MEO41/jetsuite2/README.md

# jetsuite2 — micro-turbojet design, analysis and validation suite (v3)

Single-spool, centrifugal-compressor turbojets, 100–1000 N.  From a thrust target and a
mission to a Pareto-justified design with quantified envelope performance, margins,
uncertainty and a test-ready package.

```
core (sub-second, every run):
  requirements -> cycle -> speed -> compressor -> turbine -> combustor -> layout -> rotor -> mechanical -> geometry -> cad
analysis (opt-in, cached, value-hash invalidated like everything else):
  maps -> offdesign -> envelope -> transient -> testbench      assess, combustor1d, life, rotordyn, manufacturing
studies (on the fast chain): sweep, doe, optimize (NSGA-II), uq (LHS Monte Carlo), sensitivity (Morris)
hand-off: export cfd/fea packages -> external solver -> ingest results as L3 overrides
test: virtual test bench, instrumentation plan, abort criteria, correlation / calibration against test data
```

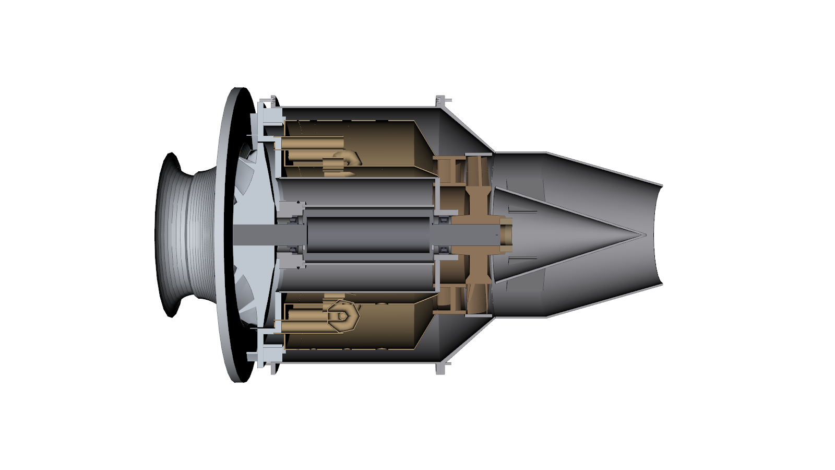
[picture p1: docs/img/p500_section.png]
500 N design, meridional section


## Install

```powershell
uv venv --python 3.12 .venv
$env:VIRTUAL_ENV="$PWD\.venv"; uv pip install -e . pytest
.venv\Scripts\jet --help
```

## Quick start

```powershell
jet new designs\p500 --thrust 500                    # create + core chain (0.4 s)
jet set -d designs\p500 compressor.material=Al2618-T61 --run
jet converge -d designs\p500
jet analyze all -d designs\p500                      # maps, running line, envelope, transients, assessment, life, ... (dependency waves run in parallel processes; --serial, --workers N)
jet status -d designs\p500                           # fidelity tier / staleness / ingested overrides per stage
jet rules -d designs\p500 --all
jet study doe opr_bs --spec '{"variables": {"cycle.OPR": [3.2, 4.6], "compressor.backsweep_deg": [15, 40]}, "n": 32}' -d designs\p500
jet study optimize pareto --spec '{"variables": {"cycle.OPR": [3.2, 4.6], "cycle.T04_K": [1080, 1200]}, "objectives": {"mass_kg": "min", "TSFC": "min"}, "pop": 24, "generations": 10}' -d designs\p500
jet study uq bands -d designs\p500                   # thrust, TSFC, margins as p05/p50/p95
jet study sensitivity rank -d designs\p500
jet export cfd compressor -d designs\p500            # handoff/compressor_cfd: curves, flowpath.step, case.json, ingest_template.json
jet ingest designs\p500\handoff\compressor_cfd\ingest_template.json --run -d designs\p500
jet correlate test_run.csv --calibrate -d designs\p500
jet plot all -d designs\p500                         # layered compressor map (PNG/SVG/HTML), turbine map, Smith/Balje, Campbell
jet freeze -d designs\p500 --by me --note "PDR"      # sign-off snapshot (hash-verifiable); `jet cad` / `jet export` need it (or --unfrozen-ok)
jet compare designs\p500 designs\p500_sched --out designs\p500_sched\compare.md   # side-by-side: rules, margins with bands, running lines, map overlay
jet fe disc -d designs\p500 --ingest                 # CalculiX axisymmetric disc case (native ccx or WSL), ingested as L3 stress
jet fe impeller -d designs\p500 --ingest             # impeller hub case (blades as smeared traction)
jet l3 -d designs\p500                               # every in-suite L3 solve, ingest, re-run, before/after delta (analysis/l3_delta.md)
jet validate paper                                   # three commercial engines modelled from their datasheets, errors reported (docs/validation.md)
jet rig compressor -d designs\p500_sched             # cold-flow compressor test article, drive, instrumentation, run matrix -> handoff/compressor_rig/
jet cfd -d designs\p500_sched --iters 1200           # impeller passage CFD: SU2 RANS-SST, rotating frame, H-mesh, throttle continuation to the design flow; ingest gated (energy balance, docs/validation.md)
jet analyze thermal -d designs\p500                  # secondary air, thermal network (rim/bore/bearing T predicted), oil system, bearing abort setting
jet analyze throughflow -d designs\p500              # impeller meridional through-flow: blade loading, hub-to-shroud incidence, Cm field (L2.5)
jet dashboard -d designs\p500                        # one self-contained HTML: headline, rules with bands, stage status, every plot
jet ecu -d designs\p500_sched                        # controller export: schedules.csv, limits.json, logic.md (state machine, limiter arbitration, faults)
jet drawings -d designs\p500_sched                   # shaft / housings / casing half-section drawings (SVG+PNG) with ISO fits -> handoff/drawings/
jet cam impeller -d designs\p500_sched               # CAM package: blade surface grids, hub/shroud curves, STEP, fillet spec (+ fillet attempt); needs a frozen design
jet set -d designs\p500 control.bleed_enabled=true control.igv_enabled=true --run   # variable geometry / control as design objects
jet validate                                         # every method vs the validation database (`jet validate rigs`: HECC/CC3 surge calibration)
jet cad -d designs\p500 ; jet report -d designs\p500 ; jet readiness -d designs\p500
```

## What v3 adds over v2

* **Fidelity ladder** — every stage carries a tier (L0/L1/L2/L3); `jet status` shows where each
  component stands; ingested solver/test results override stage values with provenance and
  re-trigger the graph; rules carry the tier of the load they were evaluated at.
* **L2 component physics** — mean-line loss models for the compressor (Oh/Aungier set, spanwise
  inducer choke, stall indicators, vaned-diffuser throat/incidence) and the turbine
  (Ainley-Mathieson/Dunham-Came with Kacker-Okapuu scaling), validated against independent
  code and literature (`docs/validation.md`).  1-D combustor network.  Rotordynamics campaign.
* **Quality assessment** — Balje/Cordier placement, slip by four methods with the disagreement
  surfaced, de Haller / diffusion / Coppage loading, incidence across the running line, diffuser
  throat and two-zone mixing, backsweep trade study, Smith chart, Zweifel, hub reaction.
* **Off-design, envelope, transients** — maps with surge and choke lines, running line with
  surge margin, altitude/Mach/dT envelope, start / slam / decel / hot & hung start / overspeed /
  flameout on the rotor inertia.
* **Life** — Larson-Miller creep over a mission, Manson LCF with start thermal stress, bearing
  L10 with lubrication, containment.
* **Optimisation and UQ** — DOE (LHS/Sobol), NSGA-II with the rules as constraints, RBF
  surrogates with leave-one-out error, Morris sensitivity, Monte-Carlo UQ with the validation
  errors as default bands; every study records the base-design hash and is flagged stale.
* **Test loop** — virtual test bench (log CSV, plots), instrumentation plan, abort criteria,
  test-readiness report, correlation and calibration against measured data.
* **Manufacturability** — tolerance stack-up, ISO 21940 balance requirement, 5-axis
  machinability screen, process-dependent allowables, BOM with part numbers and cost/lead.

## Verification

`pytest` — v2 suite (gas model, invalidation, rotordynamics closed forms, thrust sweep,
boomsonic_v0 regression) plus `tests/test_v3.py` (tabulated thermo, loss-model validation
tolerances, tiers/ingest, maps and matching closure, studies).  `jet validate` prints the
model-vs-reference table (`docs/validation.md`).

## Documents

`docs/architecture.md`, `docs/kernel_evaluation.md`, `docs/design_rules.md`, `docs/validation.md`, `CLAUDE.md`.
