MEO41/jetsuite2/designs/p500_sched/dashboard.html

# p500 v0055 fail not frozen

Generated 2026-09-17T06:31:28+00:00. never frozen. Every number carries its tier; a margin that mixes tiers is reported at the lowest one.

## Headline

thrust_N | airflow_kg_s | TSFC_kg_N_h | rpm | D2_mm | turbine_tip_mm | OD_mm | length_mm | mass_kg | bearing | verdict
500 | 0.8674 | 0.1192 | 7.25e+04 | 131.4 | 112.6 | 183.3 | 378.7 | 6.66 | 71902C-HC | fail

## Rules

id | rule | value | limit | margin | verdict | tier | source / band
REQ-1 | thrust target inside supported range | 500 | 1000 N | +50.0 % | pass | L0 | brief: 100-1000 N
REQ-2 | thrust target above minimum | 500 | 100 N | +400.0 % | pass | L0 | brief: 100-1000 N
REQ-3 | design Mach subsonic (pitot intake model) | 0 | 1 | +100.0 % | pass | L0 | intake model: normal shock + duct
CYC-1 | OPR within single-stage centrifugal practice | 4 | 5 | +20.0 % | pass | L1 | Dixon & Hall ch.7; micro-turbojet fleet 2.5-4.5
CYC-2 | OPR above useful minimum | 4 | 2.2 | +81.8 % | pass | L1 | cycle: specific thrust collapses below ~2.2
CYC-3 | T04 within uncooled cast-wheel practice | 1150 | 1250 | +8.0 % | pass | L1 | IN-713LC/MAR-M247 uncooled rotor practice (JetCat/AMT class 1050-1200 K)
CYC-4 | T04 above combustor stability floor | 1150 | 950 | +21.1 % | pass | L1 | lean stability at idle/design
CYC-5 | compressor exit temperature vs aluminium impeller limit (info) | 461.1 | - K | - | info | L1 | materials.T_max
CYC-6 | nozzle pressure ratio | 1.893 | - - | - | info | L1 | -
CYC-7 | fuel-air ratio below 60 % stoichiometric | 0.01928 | 0.04098 | +53.0 % | pass | L1 | combustor: overall phi < 0.6
SPD-1 | inducer shroud relative Mach at design | 1.095 | 1.3 | +15.8 % | pass | L1 | fielded micro-turbojet band 1.10-1.33 (boomsonic_v0 A3R.1)
SPD-2 | design rpm vs turbine AN2 limit | 7.25e+04 | 8.52e+04 rpm | +14.9 % | pass | L1 | AN2 with IN713LC allowable 436 MPa at 1030 K, margin 1.25
SPD-2b | design rpm vs turbine disc bore-stress limit | 7.25e+04 | 7.494e+04 rpm | +3.3 % | pass | L1 | bored IN713LC wheel, allowable 631 MPa at 750 K, k_peak 1.3
SPD-3 | design rpm vs bearing DN limit | 7.25e+04 | 8.095e+04 rpm | +10.4 % | pass | L1 | bearing 71902C-HC DN 1.5e+06 x 0.85
SPD-4 | impeller tip speed allowed by material (info: set by work, see COMP-3) | 454.1 | - m/s | - | info | L1 | Ti-6Al-4V yield at Tt3
COMP-1 | inducer shroud relative Mach | 1.095 | 1.3 | +15.8 % | pass | L1 | fielded micro-turbojet band (boomsonic A3R.1)
COMP-2 | impeller tip speed U2 | 498.8 | 620 m/s | +19.5 % | pass | L1 | Ti impellers ~550-600 m/s, Al ~450-500 (Dixon; Rodgers)
COMP-3 | exducer root stress at MCS vs allowable (root sized to the limit) | 602.6 | 602.6 MPa | +0.0 % | pass | L1 | Ti-6Al-4V yield at 461 K / SF 1.0
COMP-4 | impeller material temperature (Tt3) | 461.1 | 673 K | +31.5 % | pass | L1 | Ti-6Al-4V T_max
COMP-5 | exit width ratio b2/D2 | 0.05856 | 0.03 | +95.2 % | pass | L1 | narrow exits lose efficiency (Rodgers): b2/D2 >= 0.03
COMP-6 | relative diffusion ratio W1s/W2 | 1.717 | 2 | +14.1 % | pass | L1 | Dixon & Hall / Rodgers: W1s/W2 <= ~1.8-2.0 for attached flow
COMP-7 | inducer throat choke margin at design | 0.486 | 0.1 | +386.0 % | pass | L1 | Rodgers: design at <= 90 % of throat choke flow (boomsonic A3R.5)
COMP-7b | inducer throat not choked at design | 0.486 | 0 | +48.6 % | pass | L1 | throat mass-flow function
COMP-8 | radius ratio r2/r1s | 1.563 | 1.3 | +20.3 % | pass | L1 | Aungier: 1.4-2.2 for a radial impeller
COMP-9 | radius ratio r2/r1s upper | 1.563 | 2.3 | +32.0 % | pass | L1 | Aungier: 1.4-2.2 for a radial impeller
COMP-10 | impeller exit absolute Mach | 0.9246 | 1.1 | +15.9 % | pass | L1 | vaned diffuser LE tolerates ~M 1.1 (Japikse)
COMP-11 | diffuser inlet flow angle from radial | 70.02 | 78 | +10.2 % | pass | L1 | vaneless stability: alpha < ~78 deg (Senoo)
COMP-12 | estimated vs assumed stage efficiency |diff| | 0.00235 | 0.03 | +92.2 % | pass | L1 | consistency: run `jet converge`
COMP-13 | backsweep angle | 30 | 45 | +33.3 % | pass | L1 | manufacturing/loading practice 15-45 deg
COMP-14 | backsweep angle minimum for stability | 30 | 15 | +100.0 % | pass | L1 | range/stability practice
COMP-15 | implied diffuser total-pressure loss | 0.08097 | 0.12 | +32.5 % | pass | L1 | impeller/diffuser split: 3-10 % typical
TURB-1 | stage loading psi | 1.46 | 2.4 | +39.2 % | pass | L1 | Smith chart: efficiency falls fast above ~2.2
TURB-2 | stage loading psi minimum | 1.46 | 1.2 | +21.7 % | pass | L1 | below ~1.2 the annulus becomes very short
TURB-3 | rotor-exit hub/tip ratio | 0.62 | 0.55 | +12.7 % | pass | L1 | practice 0.6-0.85 for a single stage
TURB-4 | rotor-exit hub/tip ratio upper | 0.62 | 0.88 | +29.5 % | pass | L1 | very short blades: clearance losses
TURB-5 | blade root stress at MCS x margin vs allowable | 372.2 | 436 MPa | +14.6 % | pass | L1 | IN713LC min(yield, creep) at 1030 K; margin 1.25
TURB-6 | rotor metal temperature vs material limit | 1030 | 1223 K | +15.8 % | pass | L1 | IN713LC T_max
TURB-7 | NGV metal temperature vs material limit | 1150 | 1223 K | +6.0 % | pass | L1 | IN713LC T_max
TURB-8 | NGV exit Mach | 0.8164 | 1.05 | +22.2 % | pass | L1 | subsonic/transonic NGV practice
TURB-9 | rotor exit absolute Mach | 0.376 | 0.6 | +37.3 % | pass | L1 | jet-pipe entry Mach; boomsonic R7.1 annulus cap
TURB-10 | estimated vs assumed turbine efficiency |diff| | 0.001809 | 0.03 | +94.0 % | pass | L1 | consistency: run `jet converge`
TURB-11 | AN2 (rotor annulus x rpm^2) at MCS | 3.554e+07 | 4.5e+07 m2rpm2 | +21.0 % | pass | L1 | uncooled cast wheels: JetCat/AMT class 2-3.5e7, ceiling ~4.5e7 m2 rpm2
TURB-12 | turbine tip diameter (info) | 112.6 | - mm | - | info | L1 | -
COMB-1 | reference velocity | 14.36 | 25 m/s | +42.5 % | pass | L1 | Lefebvre: annular 15-25 m/s; micro practice ~20
COMB-2 | reference velocity minimum | 14.36 | 12 m/s | +19.7 % | pass | L1 | low U_ref wastes volume
COMB-3 | liner residence time | 2.5 | 2.5 ms | +0.0 % | pass | L1 | vaporiser combustors 4-7 ms (JetCat/AMT class)
COMB-4 | liner length / height | 2.8 | 3.6 | +22.2 % | pass | L1 | practice 2.5-3.5 (Lefebvre)
COMB-5 | liner metal temperature margin (T04 vs liner T_max; film-cooled liners run cooler) | 1150 | 1403 K | +18.0 % | pass | L1 | IN625 T_max + 150 K film credit
COMB-6 | heat release rate | 143.8 | 300 MW/m3bar | +52.1 % | pass | L1 | large annular 20-60, micro-turbojet vaporiser combustors up to ~300 MW/(m3 bar)
COMB-7 | air split sums to 1 | 1 | 1 | +0.0 % | pass | L1 | input check
COMB-8 | vaporiser fuel loading | 4.257 | 12 kg/h | +64.5 % | pass | L1 | practice 3-12 kg/h per tube
LAY-1 | engine outer diameter vs limit | 183.3 | - mm | - | info | L0 | requirements.max_diameter_mm
LAY-2 | engine length vs limit | 378.7 | - mm | - | info | L0 | requirements.max_length_mm
LAY-3 | bearing span / D2 (rotordynamic sanity) | 0.8223 | 2.2 | +62.6 % | pass | L0 | long spans lower the bending critical; boomsonic_v0 1.43
LAY-4 | tail cone shorter than nozzle | 0.1075 | 0.1193 | +9.9 % | pass | L0 | geometry
ROT-1 | bearing DN at MCS vs rating | 1.142e+06 | 1.5e+06 mm.rpm | +23.9 % | pass | L2 | 71902C-HC catalogue DN limit
ROT-2 | bearing temperature rating | 420 | 523 K | +19.7 % | pass | L2 | 71902C-HC T_max
ROT-3 | first bending critical / MCS | 2.5 | 1.25 | +100.0 % | pass | L2 | API 684 separation margin practice (25 %)
ROT-4 | rigid-body criticals below 60 % speed (soft mount) | 0.4024 | 0.6 | +32.9 % | pass | L2 | traverse rigid modes below idle-to-cruise band
ROT-5 | journal torsional stress | 30.46 | 175.3 MPa | +82.6 % | pass | L2 | AISI4340 0.577 Fty / SF 3
ROT-6 | tube torsional stress | 3.013 | 175.3 MPa | +98.3 % | pass | L2 | AISI4340 0.577 Fty / SF 3
ROT-7 | shaft tunnel fits inside combustor inner casing | 0.0215 | 0.03821 m | +43.7 % | pass | L2 | layout: tunnel OD + 3 mm gap
ROT-8 | bearing L10 life (info) | 6.251e+06 | - h | - | info | L2 | ISO 281 basic rating (no thermal factors)
MECH-1 | impeller disc peak stress at MCS vs yield | 738.5 | 617 MPa | -19.7 % | fail | L1 | Ti-6Al-4V min-basis yield at 441 K; stress from L3 FE (CalculiX 2.21 axisymmetric CAX4 impeller)
MECH-2 | impeller burst speed ratio | 1.531 | 1.2 | +27.6 % | pass | L1 | 14 CFR 33.27 style; Robinson k 0.85
MECH-3 | inducer root radial stress vs yield | 130.9 | 617 MPa | +78.8 % | pass | L1 | Ti-6Al-4V yield
MECH-4 | exducer root stress (from compressor stage, sized to limit) vs allowable | 602.6 | 602.6 MPa | +0.0 % | pass | L1 | compressor.COMP-3
MECH-5 | turbine disc peak stress vs bore allowable | 967.1 | 630.8 MPa | -53.3 % | fail | L1 | IN713LC allowable at bore 750 K; stress from L3 FE (CalculiX 2.21 axisymmetric CAX4 disc, 23)
MECH-6 | turbine disc average stress vs rim creep allowable | 398.4 | 615.9 MPa | +35.3 % | pass | L1 | IN713LC allowable at rim 950 K
MECH-7 | turbine burst speed ratio | 1.267 | 1.2 | +5.6 % | pass | L1 | 14 CFR 33.27 style; Robinson k 0.85
MECH-8 | turbine blade root (from turbine stage) | 297.8 | 436 MPa | +31.7 % | pass | L1 | turbine.TURB-5 (no margin factor here)
MECH-9 | impeller clamp load retained hot | 5.897e+04 | 1.435e+04 N | +311.0 % | pass | L1 | tie-shaft preload minus thermal relaxation and gas load >= 20 % of preload
GEO-1 | dry mass estimate vs limit | 6.66 | - kg | - | info | L0 | requirements.max_mass_kg
GEO-2 | thrust/weight (info) | 7.653 | - - | - | info | L0 | -
GEO-3 | flange screws count (info) | 15 | - | - | info | L0 | ISO 4762 M2
CTL-8 | IGV actuation rate required vs capability | 9.375 | 30 deg/s | +68.8 % | pass | L1 | schedule slope x fastest class acceleration (idle -> 95 % in 4 s)
CTL-9 | IGV failure position defined (open = 0 deg, closed = max) | 1 | 1 | +0.0 % | pass | L1 | a failed actuator must leave the vanes at a known position; the transient stage runs the failed case
CTL-1 | bleed fraction at full opening | 0.15 | 0.15 | +0.0 % | warn | L1 | handling bleeds 5-15 % (Saravanamuttoo)
CTL-2 | variable nozzle area range A8_low / A8_design | 1.3 | 1.35 | +3.7 % | warn | L1 | translating-plug / iris practice 1.0-1.3
CTL-3 | IGV pre-swirl range | 25 | 40 | +37.5 % | pass | L1 | IGV practice <= 30-40 deg
CTL-4 | accel line above decel line everywhere | 0.7 | 0.3 | +133.3 % | pass | L1 | limiter ordering: accel multiplier - decel multiplier >= 0.3
CTL-5 | accel limiter at design speed | 1.183 | 1.35 | +12.3 % | pass | L1 | practice: 1.1-1.3 x steady Wf/P3 near max
CTL-6 | idle governor speed | 0.5 | 0.35 | +42.9 % | pass | L1 | micro-turbojet idle 30-50 %
CTL-7 | start ramp rate (fraction of accel line per s) | 0.25 | 1 | +75.0 % | pass | L1 | faster ramps raise the start T04 peak and the disc thermal gradient (F3)
ASS-1 | compressor quality score (mean of items) | 0.8499 | 0.75 | +13.3 % | pass | L2 | assessment items AQ-C*
ASS-2 | diffuser quality score | 1 | 0.75 | +33.3 % | pass | L2 | AQ-D*
ASS-3 | turbine quality score | 0.9805 | 0.75 | +30.7 % | pass | L2 | AQ-T*
TF-1 | pressure-side relative velocity stays positive (no blade overload / reverse flow) | 3.882 | 0 m/s | +388.2 % | pass | L2 | Stanitz loading on the blade-aligned through-flow (L2.5)
TF-2 | suction-side deceleration ratio W_ss,max / W_ss,exit (worst streamline) | 1.933 | 1.6 | -20.8 % | fail | L2 | Dean / Rodgers: suction-surface diffusion <= ~1.6 before separation
TF-3 | leading-edge incidence spread hub -> shroud | 4.258 | 6 deg | +29.0 % | pass | L2 | twist matched to the inlet velocity profile
TF-4 | exit meridional velocity distortion Cm_shroud / Cm_hub | 1.031 | 1.5 | +31.3 % | pass | L2 | curvature-driven hub/shroud imbalance feeding the diffuser
TF-5 | blade loading parameter (W_ss - W_ps) / W_mean, max | 1.963 | 0.9 | -118.1 % | warn | L2 | Aungier / Stanitz practice 0.7-1.0
C1D-1 | primary-zone equivalence ratio | 1.201 | 1.4 | +14.2 % | pass | L2 | Lefebvre: primary zone phi 0.8-1.4 for vaporiser combustors
C1D-1b | primary-zone equivalence ratio minimum | 1.201 | 0.8 | +50.1 % | pass | L2 | Lefebvre: phi_pz >= 0.8 for stability
C1D-2 | primary-zone Damkohler number (residence/chemical) | 25.44 | 5 | +408.9 % | pass | L2 | Da >> 1 required for stable combustion (global kinetics; order of magnitude)
C1D-3 | combustion efficiency (Lefebvre theta correlation) | 0.9851 | 0.98 | +0.5 % | pass | L2 | theta correlation calibrated on the fleet (+/-2 pts)
C1D-4 | lean blow-out margin at design (phi_pz / phi_LBO) | 2.402 | 1.5 | +60.2 % | pass | L2 | Lefebvre stability loop
C1D-5 | lean blow-out margin at idle | 1.332 | 1.2 | +11.0 % | pass | L2 | Lefebvre stability loop at the idle point
C1D-6 | pattern factor into the turbine | 0.2698 | 0.3 | +10.1 % | pass | L2 | Lefebvre: PF 0.2-0.35 for short annular liners
C1D-7 | liner wall temperature vs material limit | 978 | 1253 K | +21.9 % | pass | L2 | IN625 T_max; radiation/convection/film balance
C1D-8 | altitude relight index (phi_LBO windmilling / phi_LBO design) | 1.103 | 2.5 | +55.9 % | pass | L2 | Lefebvre loading at 6000 m, N 0.12
MAP-1 | design-point surge margin (loss-model map, SAE definition) | 0.1726 | 0.15 | +15.1 % | warn | L2 | rig-calibrated stall model (HECC/CC3); band +/-0.077 = rig 0.077 (RSS) = 0.077 +0.173 - 0.077 = +0.096 vs limit 0.150: fails with the band (passes nominally); dominant term: rig 0.077
MAP-2 | design-point choke margin (flow to choke / design flow - 1) | 0.1009 | 0.08 | +26.2 % | pass | L2 | inducer / diffuser throat choke on the design speed line
MAP-3 | L2 loss-model compressor efficiency vs L1 estimate |diff| | 0.02339 | 0.04 | +41.5 % | pass | L2 | consistency between fidelity tiers
MAP-4 | L2 loss-model turbine efficiency vs L1 estimate |diff| | 0.03783 | 0.05 | +24.3 % | pass | L2 | consistency between fidelity tiers
MAP-5 | design-point vaned-diffuser incidence | -3.082 | 4 | +177.1 % | pass | L2 | vane stall onset ~ +4-6 deg (Japikse)
MAP-6 | compressor loss-model PR at design vs cycle OPR |diff|/OPR | 0.06767 | 0.06 | -12.8 % | warn | L2 | the sized geometry should deliver the cycle pressure ratio within the loss-model accuracy
OD-1 | minimum surge margin along the running line | 0.06865 | 0.1 | -31.3 % | fail | L2 | SAE margin from the L2 map at N 1.05; band +/-0.077 = rig 0.077 (RSS) = 0.077 +0.069 - 0.077 = -0.008 vs limit 0.100: fails with the band; dominant term: rig 0.077
OD-2 | max-thrust point recovers the design thrust | 0.9872 | 0.95 | +3.9 % | warn | L2 | map-based matching vs design-point cycle (consistency)
OD-3 | idle speed fraction | 0.4 | 0.35 | +14.3 % | pass | L2 | micro-turbojet idle 30-40 % (JetCat 33-35 %)
OD-4 | idle surge margin | 0.3001 | 0.08 | +275.1 % | pass | L2 | low-speed operability (boomsonic_v0 risk 4.2); band +/-0.159 = rig 0.077 + igv extrapolation 0.140 (RSS) = 0.159 +0.300 - 0.159 = +0.141 vs limit 0.080: passes with the band; dominant term: igv extrapolation 0.140
ENV-1 | fraction of envelope grid points cleared (converged, SM >= floor) | 0.7083 | 0.9 | -21.3 % | warn | L2 | SM floor 0.08; L2 maps
ENV-2 | worst-case surge margin over the envelope | -0.04617 | 0.08 | -157.7 % | fail | L2 | at alt 9000.0 m, M 0.6, dT -20.0 K; band +/-0.077 = rig 0.077 (RSS) = 0.077 -0.046 - 0.077 = -0.123 vs limit 0.080: fails with the band; dominant term: rig 0.077
ENV-3 | sea-level static max thrust vs design thrust | 0.9872 | 0.95 | +3.9 % | warn | L2 | envelope max-power point at SLS (T04- or N-limited)
TRN-1 | start reaches idle | 1 | 1 | +0.0 % | pass | L2 | start sequence simulation
TRN-2 | start light-off to self-sustain time | 7.65 | 8 s | +4.4 % | warn | L2 | micro-turbojet practice 3-8 s
TRN-3 | slam acceleration idle -> 95 % time | 7.05 | 6 s | -17.5 % | warn | L2 | class practice 3-6 s (JetCat ~4 s)
TRN-4 | minimum surge margin during the slam acceleration | 0.1719 | 0.05 | +243.8 % | pass | L2 | transient excursion toward surge at N 0.81; band +/-0.082 = rig 0.077 + transient quasi-steady model form 0.030 (RSS) = 0.082 +0.172 - 0.082 = +0.090 vs limit 0.050: passes with the band; dominant term: rig 0.077
TRN-5 | T04 peak during acceleration vs limit | 1200 | 1200 K | +0.0 % | pass | L2 | over-temperature limiter (the limiter holds the peak at the limit)
TRN-6 | deceleration 100 % -> idle time | 0.8 | 8 s | +90.0 % | pass | L2 | class practice
TRN-7 | hot start T04 peak (schedule x1.5) | 1200 | 1300 K | +7.7 % | pass | L2 | abnormal case: rich start
TRN-8 | hung start with half starter torque avoided | 0 | 1 | -100.0 % | warn | L2 | abnormal case
TRN-10 | surge margin with the IGV actuator failed (slam accel, vanes at the failure position) | 0.03416 | 0 | +3.4 % | pass | L2 | failed-open IGV at 0 deg; band +/-0.082 = rig 0.077 + transient quasi-steady model form 0.030 (RSS) = 0.082 +0.034 - 0.082 = -0.048 vs limit 0.000: fails with the band (passes nominally); dominant term: rig 0.077
TRN-9 | overspeed on governor failure (peak N / design) | 0.97 | 1.15 | +15.7 % | pass | L2 | burst margin 1.2 x MCS must cover the overspeed reached before the fuel cut
THM-1 | turbine disc rim temperature vs material limit | 1040 | 1223 K | +15.0 % | pass | L1 | IN713LC T_max; network L1 +/-40 K
THM-2 | turbine disc bore temperature vs shaft / bearing tolerance | 791.5 | 850 K | +6.9 % | pass | L1 | bore heat sinks into the shaft; L1 +/-40 K
THM-3 | rear bearing temperature vs bearing rating | 359.5 | 523 K | +31.3 % | pass | L1 | 71902C-HC T_max; Palmgren heat 197 W, oil 147.9 g/min at dT 40 K
THM-4 | secondary air (leakage + purge) fraction of core flow | 0.01039 | 0.03 | +65.4 % | pass | L1 | labyrinth 3 teeth, c 0.15 mm at r 36.1 mm (Martin)
THM-5 | rim-seal purge fraction vs ingestion minimum | 0.01039 | 0.005 | +107.8 % | pass | L1 | declared minimum (Owen); below it hot gas enters the front cavity
THM-6 | front bearing temperature vs bearing rating | 354.6 | 523 K | +32.2 % | pass | L1 | 71902C-HC T_max
THM-7 | bearing abort setting (predicted + margin) below the bearing rating | 389.5 | 523 K | +25.5 % | pass | L1 | abort = predicted 359 K + 30 K margin
THM-8 | mechanical-stage rim temperature assumption vs prediction |dT| | 89.67 | 40 K | -124.2 % | warn | L1 | assumed 950 K, predicted 1040 K; bore assumed 750 K, predicted 791 K
LIFE-1 | turbine blade creep life over the mission / scatter | 1.117e+06 | 50 h | +2233160.2 % | pass | L1 | Larson-Miller from the IN713LC creep table (C 20.0), Robinson damage
LIFE-2 | turbine disc rim creep life / scatter | 7.616e+04 | 50 h | +152221.9 % | pass | L1 | as LIFE-1
LIFE-3 | impeller bore LCF cycles / scatter | 343.3 | 500 | -31.3 % | fail | L1 | Manson universal slopes, Ti-6Al-4V
LIFE-4 | turbine bore LCF cycles incl. start thermal stress / scatter | 14.19 | 500 | -97.2 % | fail | L1 | Manson universal slopes (L1), IN713LC; bore stress 1281 MPa from L3 FE stress (CalculiX 2.21 axisymmetric CAX4 disc, 2379 elements, 2026-09); thermal dT_max 342 K; T thermal network L1 +/-40 K
LIFE-5 | bearing L10 life (ISO 281, lubrication/temperature factors) | 320.2 | 200 h | +60.1 % | pass | L1 | 71902C-HC C 4.0 kN, P_eq 358 N, oil-mist
LIFE-6 | bearing DN with the lubrication method | 1 | 1 | +0.0 % | pass | L1 | catalogue DN x lubrication factor
LIFE-7 | casing wall vs containment thickness (1/3 disc fragment at burst) | 1 | 7.262 mm | -86.2 % | warn | L1 | energy balance, AISI321 UTS at 700 K, k 3 (conceptual)
RD-1 | first forward bending critical / MCS (nominal support) | 2.5 | 1.25 | +100.0 % | pass | L2 | API 684 separation margin
RD-2 | max synchronous vibration amplitude at G2.5 residual unbalance | 1.321 | 25 um | +94.7 % | pass | L2 | ISO 1940 G2.5; 25 um pk at the wheels is a common limit for tip clearance/seal rub
RD-3 | amplification factor at the first response peak | 3.313 | 8 | +58.6 % | pass | L2 | API 684: AF < 8 for a well-damped critical
RD-4 | blade resonance crossings within the operating range | 0 | 0 | +0.0 % | pass | L2 | Campbell: exducer vs diffuser vane passing, turbine blade vs NGV passing
RD-5 | blade resonance within +/-10 % of the design speed | 0 | 0 | +0.0 % | pass | L2 | no crossing at the dwell speed
RD-6 | max bearing dynamic load at G2.5 / static capacity C0 | 0.005321 | 0.1 | +94.7 % | pass | L2 | dynamic load should stay a small fraction of C0
MFG-1 | impeller tip clearance remaining at worst-case stack-up | 0.09279 | 0.05 mm | +85.6 % | pass | L1 | tolerance chain (worst case)
MFG-2 | turbine tip clearance remaining at worst-case stack-up | 0.01 | 0.05 mm | -80.0 % | fail | L1 | tolerance chain incl. thermal growth
MFG-3 | impeller efficiency scatter from clearance tolerance (RSS) | 0.002892 | 0.01 | +71.1 % | pass | L1 | 0.3 x d(clr)/b2
MFG-4 | balancing: required residual per plane vs achievable | 0.3064 | 0.05 g mm | +512.9 % | pass | L1 | ISO 21940 G2.5 at 72500 rpm: 0.306 g mm per plane
MFG-5 | minimum impeller passage width vs cutter | 12.26 | 3 mm | +308.7 % | pass | L1 | 5-axis cutter access
MFG-6 | impeller blade wrap / pitch (axial-view overlap) | 1.572 | 1.6 | +1.8 % | warn | L1 | flank-milling reach
MFG-7 | impeller features flagged | 0 | 0 | +0.0 % | pass | L1 | machinability screen
MFG-8 | turbine casting features flagged | 0 | 0 | +0.0 % | pass | L1 | investment-casting screen
MFG-9 | exducer root stress vs process-adjusted allowable | 602.6 | 602.6 MPa | +0.0 % | pass | L1 | billet-5axis: allowable x 1.0 (root sized to the limit)
MFG-10 | turbine root stress vs process-adjusted allowable | 297.8 | 370.6 MPa | +19.7 % | pass | L1 | investment-cast: allowable x 0.85
TB-1 | virtual run completed without abort | 0 | 0 | +0.0 % | pass | L2 | abort criteria
TB-2 | max thrust reached on the bench vs design | 1.047 | 0.95 | +10.2 % | pass | L2 | throttle step to 100 %

## Stages

stage | kind | tier | last run | stale | overrides (L3)
requirements | core | L0 | 2026-09-16T21:41:31 | | -
cycle | core | L1 | 2026-09-16T21:41:31 | | -
speed | core | L1 | 2026-09-16T21:41:31 | | -
compressor | core | L1 | 2026-09-16T21:41:31 | | -
turbine | core | L1 | 2026-09-16T21:41:31 | | -
combustor | core | L1 | 2026-09-16T21:41:31 | | -
layout | core | L0 | 2026-09-16T21:41:31 | | -
rotor | core | L2 | 2026-09-16T21:41:31 | | -
mechanical | core | L1 | 2026-09-17T00:34:00 | | impeller.sigma_peak_Pa [L3], turbine.sigma_peak_Pa [L3], turbine.sigma_avg_Pa [L3]
control | core | L1 | 2026-09-16T21:41:31 | | -
geometry | core | L0 | 2026-09-16T21:41:31 | | -
maps | analysis | L2 | 2026-09-16T21:45:19 | | -
offdesign | analysis | L2 | 2026-09-17T09:30:35 | | -
assess | analysis | L2 | 2026-09-16T21:26:14 | | -
throughflow | analysis | L2 | 2026-09-17T09:01:28 | | -
combustor1d | analysis | L2 | 2026-09-17T09:31:22 | | -
envelope | analysis | L2 | 2026-09-16T21:35:13 | | -
transient | analysis | L2 | 2026-09-17T09:31:22 | | -
thermal | analysis | L1 | 2026-09-17T09:30:35 | | -
life | analysis | L1 | 2026-09-17T09:31:22 | | sigma_bore_total_Pa [L3]
rotordyn | analysis | L2 | 2026-09-17T09:30:35 | | -
manufacturing | analysis | L1 | 2026-09-17T09:30:35 | | -
testbench | analysis | L2 | 2026-09-17T09:31:22 | | -

## Plots

compressor_map.png

turbine_map.png

smith_balje.png

campbell.png

envelope.png

rotordynamics.png

testbench_run.png

compressor_map.png

running_line.png

throughflow.png

transients.png

turbine_map.png

## Open findings (failed rules)

- MECH-1 impeller disc peak stress at MCS vs yield: lower U2 (OPR/backsweep), boreless mount, or a stronger material
- MECH-5 turbine disc peak stress vs bore allowable: thicker web/hub, lower rpm
- TF-2 suction-side deceleration ratio W_ss,max / W_ss,exit (worst streamline): hub 1.67, mid 1.59, shroud 1.93; unload the inducer (more incidence margin, smoother beta(m))
- OD-1 minimum surge margin along the running line: lower the running line (larger nozzle), more backsweep, or a bleed / variable geometry
- ENV-2 worst-case surge margin over the envelope: hot-day / high-Mach corners load the compressor: consider a variable nozzle or bleed
- LIFE-3 impeller bore LCF cycles / scatter: lower bore stress: boreless hub or lower U2
- LIFE-4 turbine bore LCF cycles incl. start thermal stress / scatter: slower start, thicker hub, or boreless wheel
- MFG-2 turbine tip clearance remaining at worst-case stack-up:
