MEO41/jetsuite2/designs/paper_p300/datasheet_points.csv

N_rpm | thrust_N | Wf_kg_h | EGT_K | W_kg_s | T_amb_K | P_amb_Pa
105000 | 300 | 47.04 | 1023.15 | 0.50 | 288.15 | 101325
35000 | 14 | 8.59 |  |  | 288.15 | 101325
