MEO41/jetsuite2/designs/p500_sched/handoff/ecu/schedules.csv

Nc_frac | rpm_at_design_theta | WfP3_steady_kg_s_per_Pa | accel_mult | decel_mult | bleed_frac | A8_ratio | igv_deg | T04_steady_K
0.2 | 14500.0 |  | 1.5 | 0.55 | 0.15 | 1.3 | 25.0
0.3 | 21750.0 |  | 1.5 | 0.55 | 0.15 | 1.3 | 25.0
0.4 | 29000.0 | 2.4802610105058686e-08 | 1.45 | 0.5333333333333333 | 0.15 | 1.3 | 25.0 | 863.5697973268473
0.45 | 32625.0 | 2.71035822547676e-08 | 1.4249999999999998 | 0.525 | 0.15 | 1.3 | 25.0 | 866.8142639829052
0.5 | 36250.0 | 2.6885261524721085e-08 | 1.4 | 0.5166666666666667 | 0.12222222222222222 | 1.3 | 25.0 | 818.6958404399275
0.55 | 39875.0 | 2.7389507912093985e-08 | 1.375 | 0.5083333333333333 | 0.09444444444444441 | 1.2571428571428571 | 20.83333333333333 | 803.1397178925387
0.6 | 43500.0 | 2.6745744692243385e-08 | 1.35 | 0.5 | 0.06666666666666667 | 1.2142857142857144 | 16.66666666666667 | 774.425437101337
0.65 | 47125.0 | 2.6842742808469064e-08 | 1.325 | 0.49444444444444446 | 0.038888888888888876 | 1.1714285714285715 | 12.5 | 770.5879389911961
0.7 | 50750.0 | 2.6247944885822877e-08 | 1.3 | 0.4888888888888889 | 0.011111111111111127 | 1.1285714285714286 | 8.33333333333334 | 762.1352136951889
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
