MEO41/jetsuite2/designs/p500/analysis/compressor_map.png

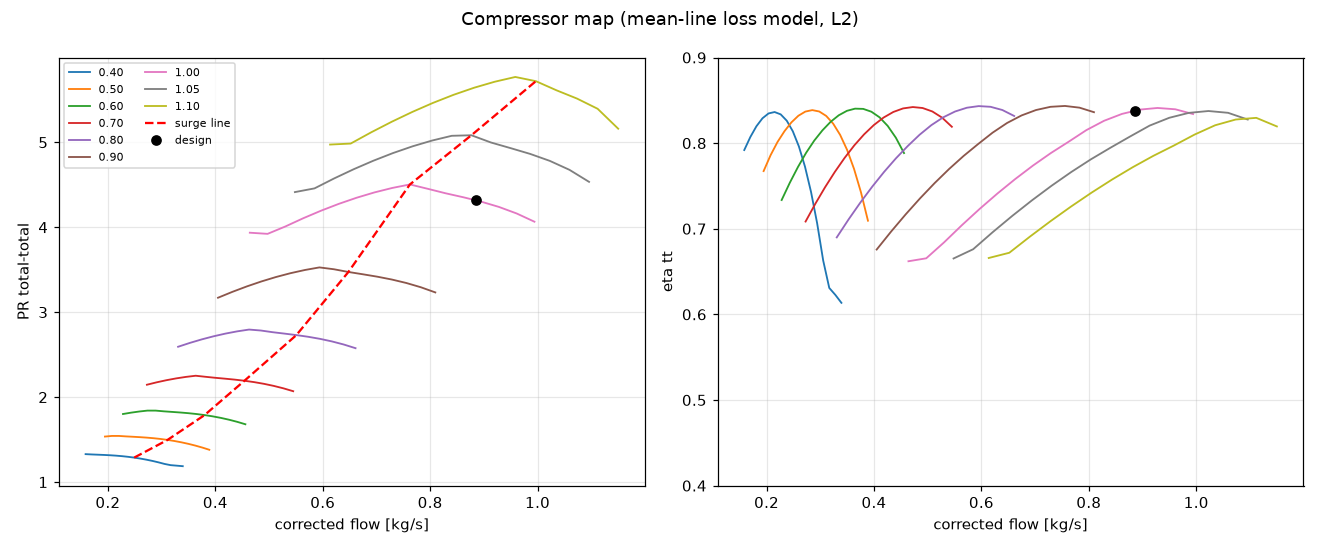
designs/p500/analysis/compressor_map.png
