MEO41/jetsuite2/designs/p500/analysis/envelope.png

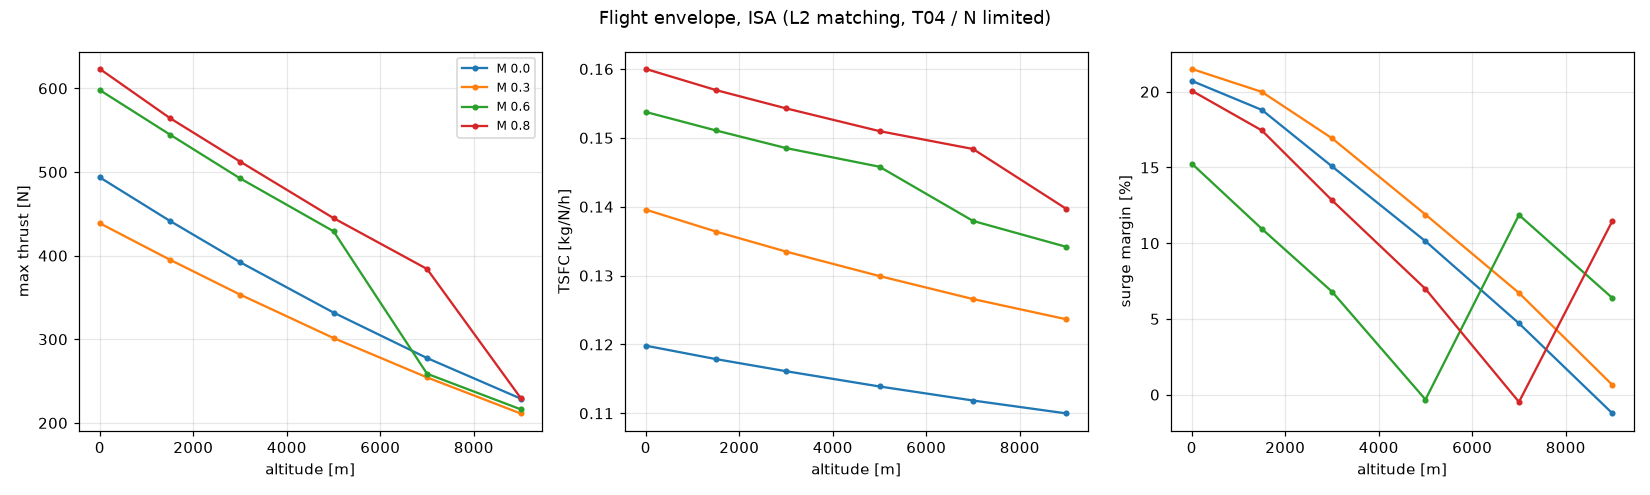
designs/p500/analysis/envelope.png
