MEO41/jetsuite2/designs/p500/analysis/rotordynamics.png

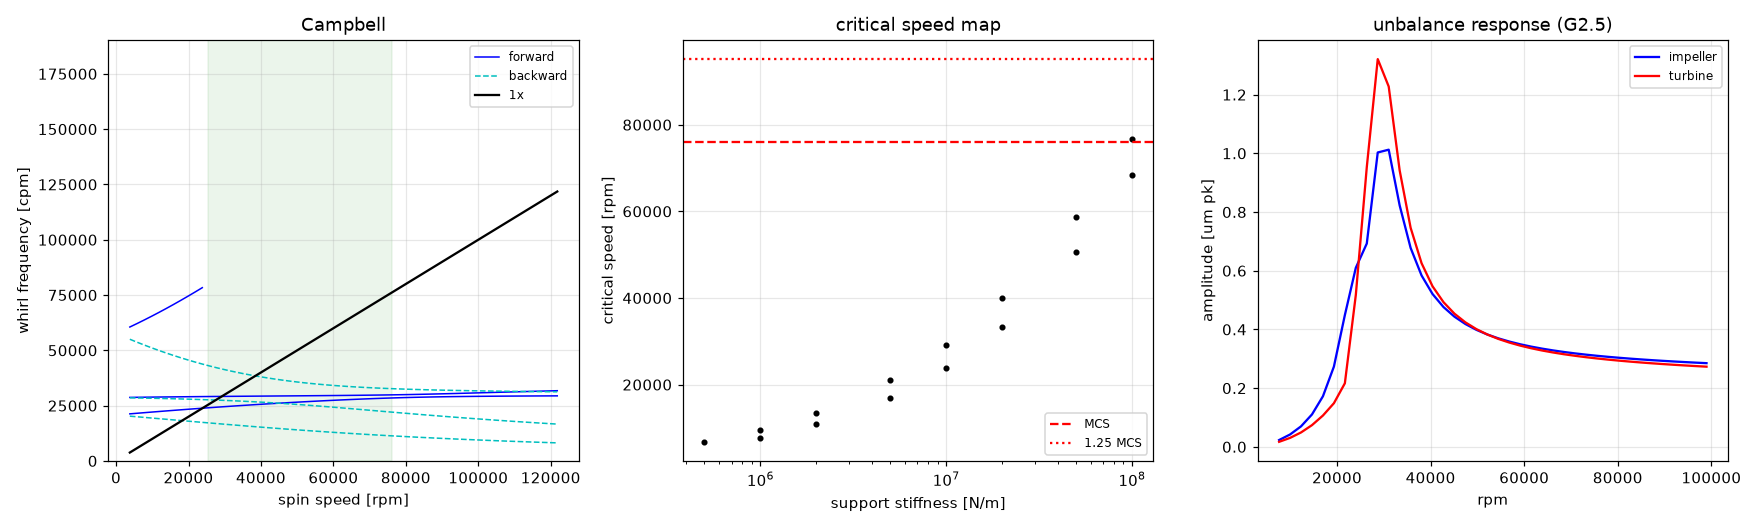
designs/p500/analysis/rotordynamics.png
