MEO41/jetsuite2/designs/p500/analysis/running_line.png

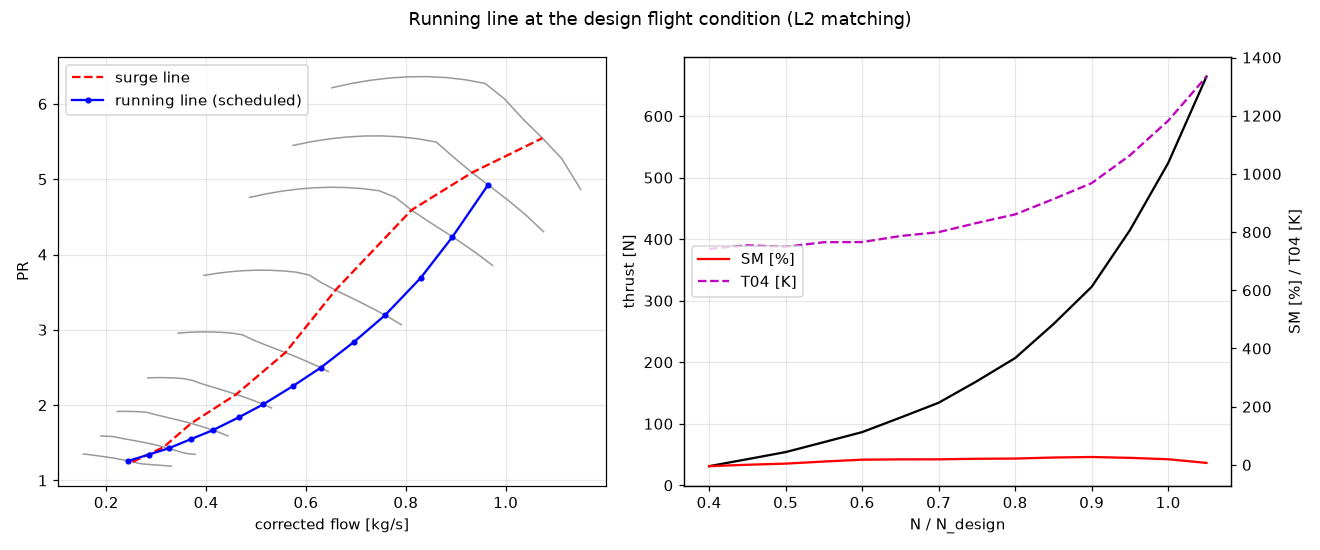
designs/p500/analysis/running_line.png
