MEO41/jetsuite2/designs/p500/analysis/throughflow.png

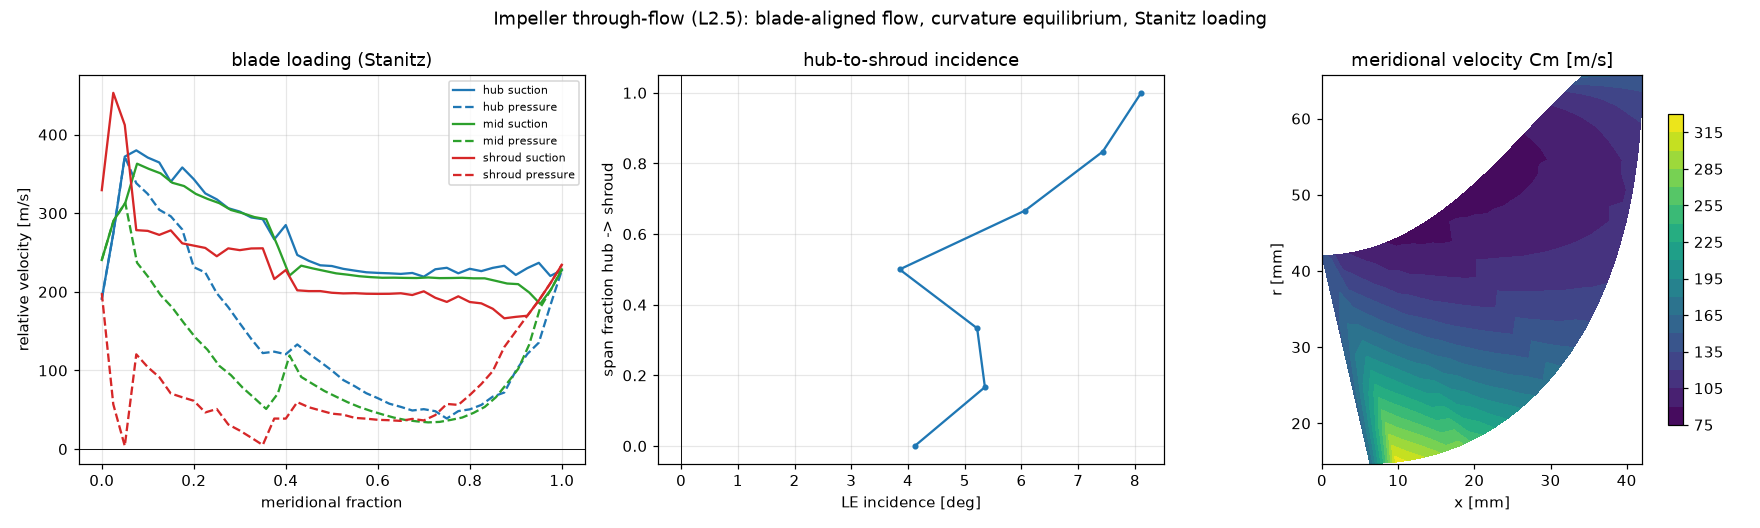
designs/p500/analysis/throughflow.png
