MEO41/jetsuite2/designs/p500/analysis/transients.png

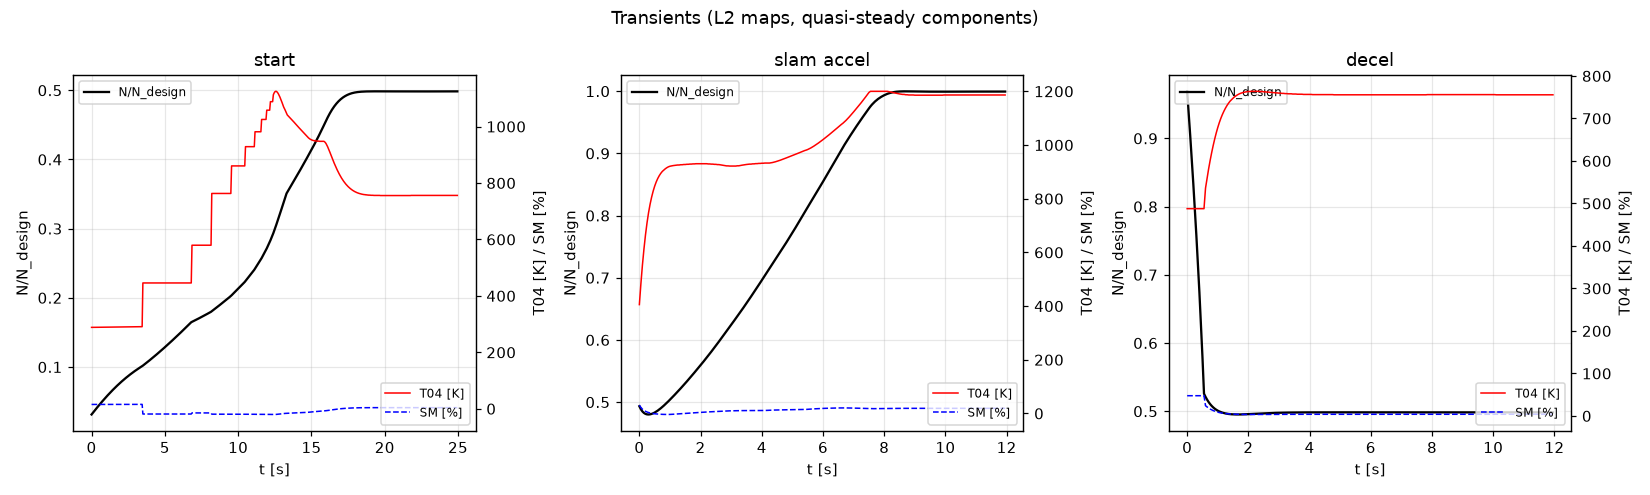
designs/p500/analysis/transients.png
