MEO41/jetsuite2/designs/p500_sched/analysis/compressor_map.png

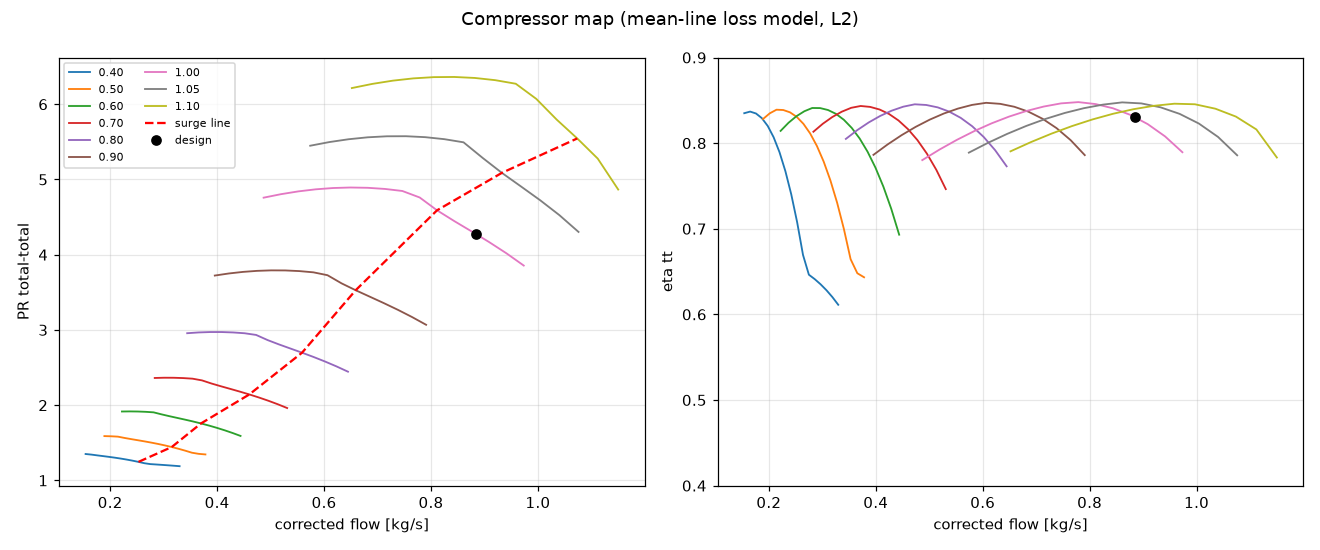
designs/p500_sched/analysis/compressor_map.png
