MEO41/jetsuite2/designs/p500_sched/analysis/transients.png

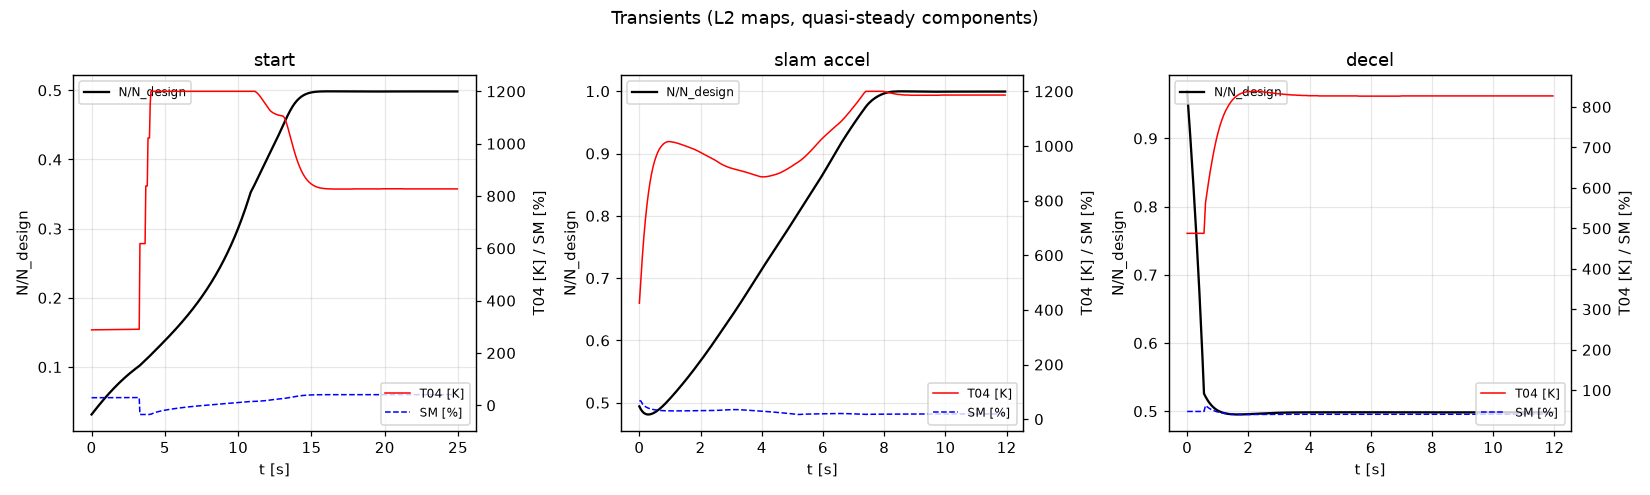
designs/p500_sched/analysis/transients.png
