MEO41/jetsuite2/designs/p500_sched/analysis/turbine_map.png

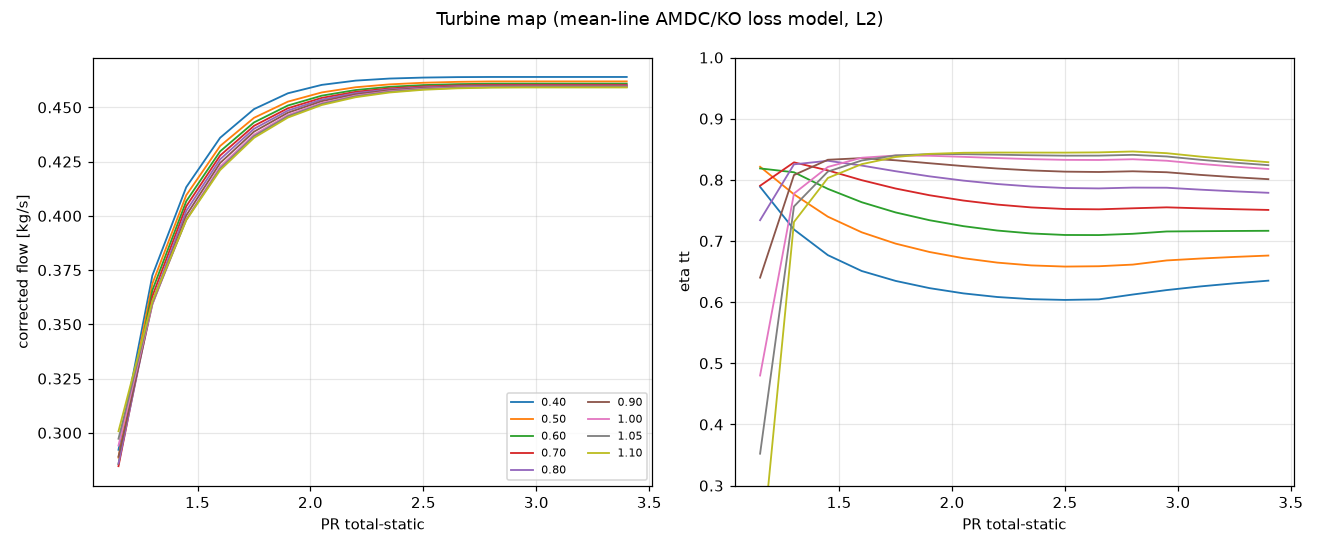
designs/p500_sched/analysis/turbine_map.png
