MEO41/jetsuite2/designs/paper_p300/analysis/turbine_map.png

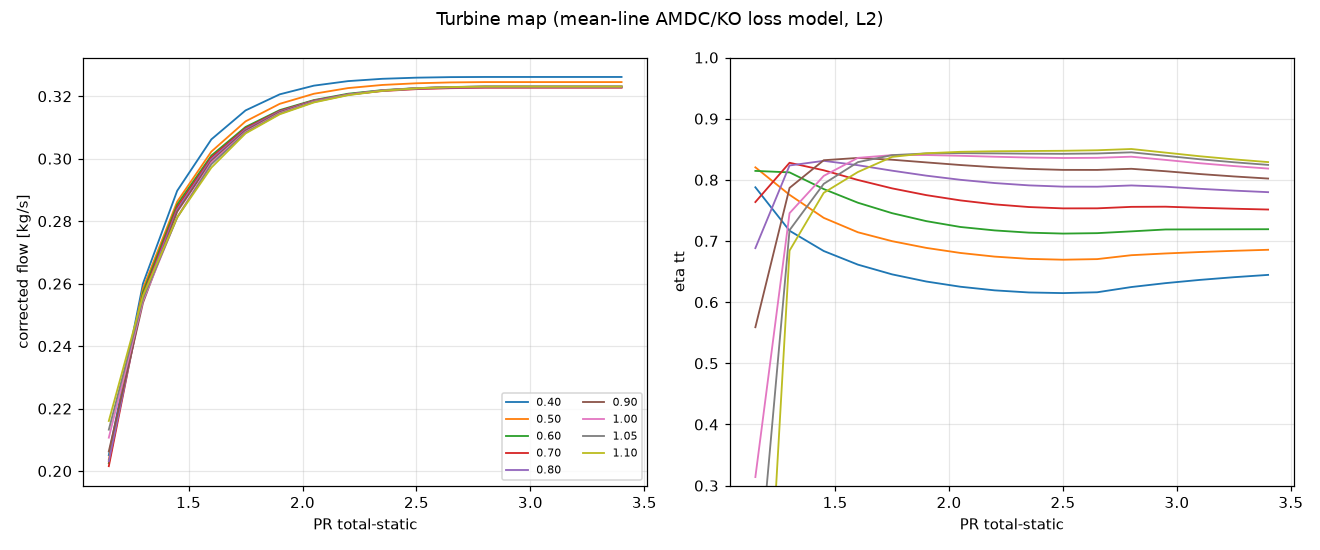
designs/paper_p300/analysis/turbine_map.png
