MEO41/jetsuite2/docs/img/p500_iso.png

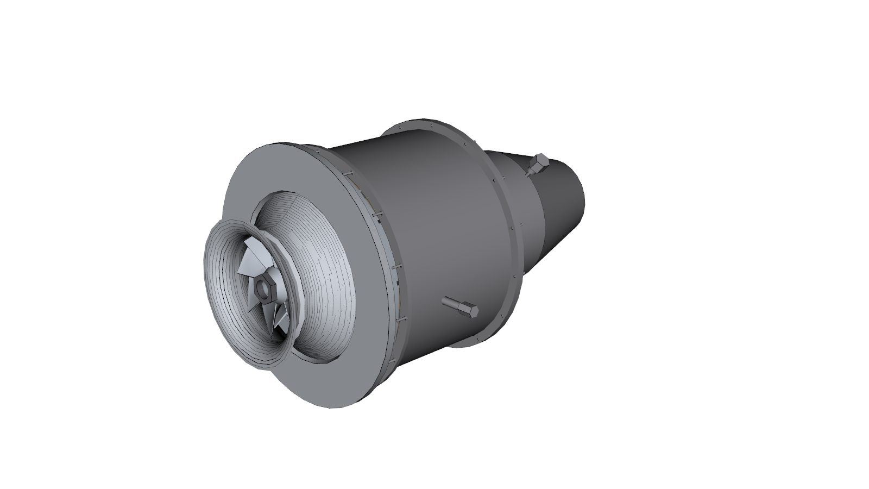
docs/img/p500_iso.png
