MEO41/jetsuite2/designs/p500_sched/cad/engine_assembly.step

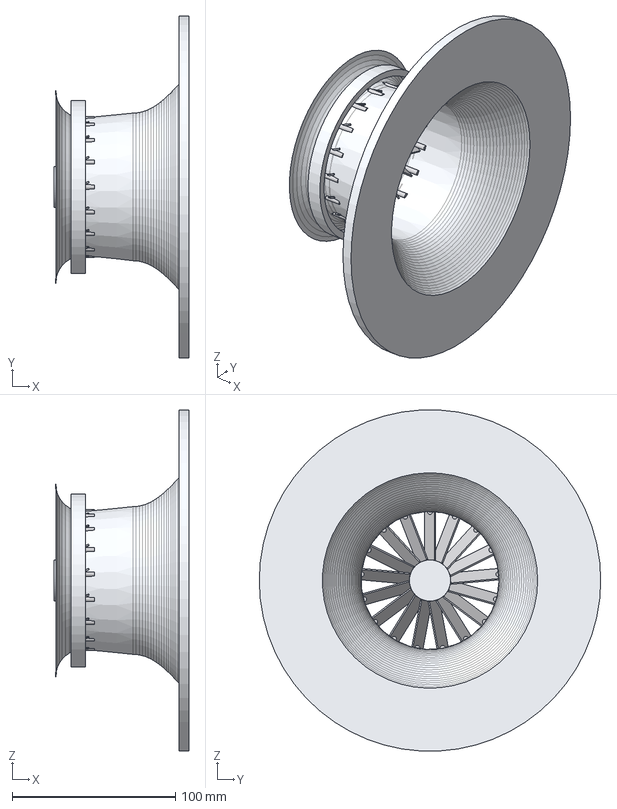
[picture p22: CAD file, 2026-09-17]
designs/p500_sched/cad/engine_assembly.step
82.7 x 209.3 x 209.0 mm
inlet_shroud
igv_vanes
igv_hub_bullet
igv_unison_ring
