MEO41/jetsuite2/designs/p500_sched/handoff/impeller_cam/main_blade.step

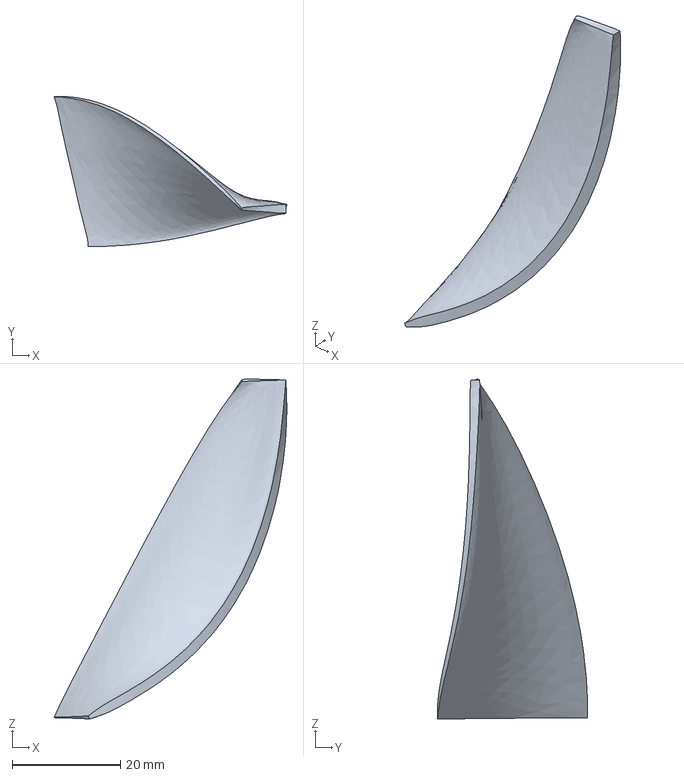
[picture p23: CAD file, 2026-09-17]
designs/p500_sched/handoff/impeller_cam/main_blade.step
42.9 x 27.7 x 62.7 mm
