MEO41/jetsuite2/designs/p500/cad/parts/inlet_shroud.step

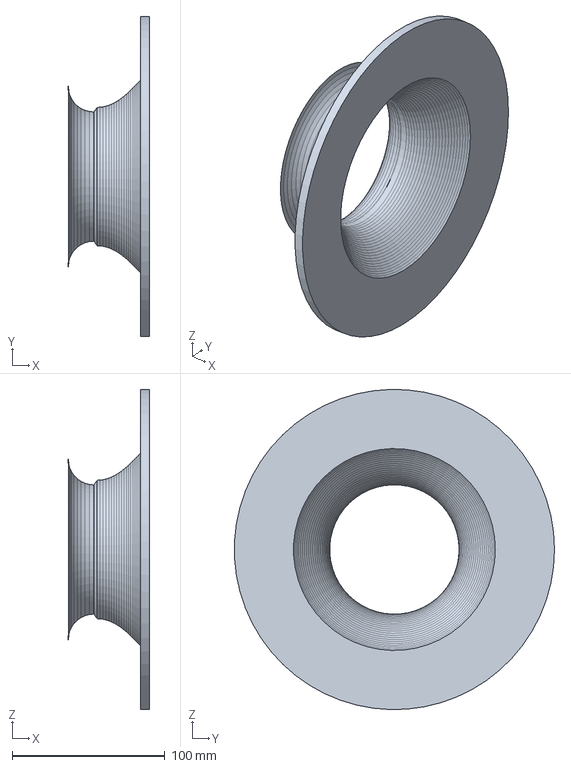
[picture p24: CAD file, 2026-09-16]
designs/p500/cad/parts/inlet_shroud.step
53.3 x 209.2 x 209.3 mm
