MEO41/jetsuite2/designs/p500_sched/cad/parts/igv_unison_ring.step

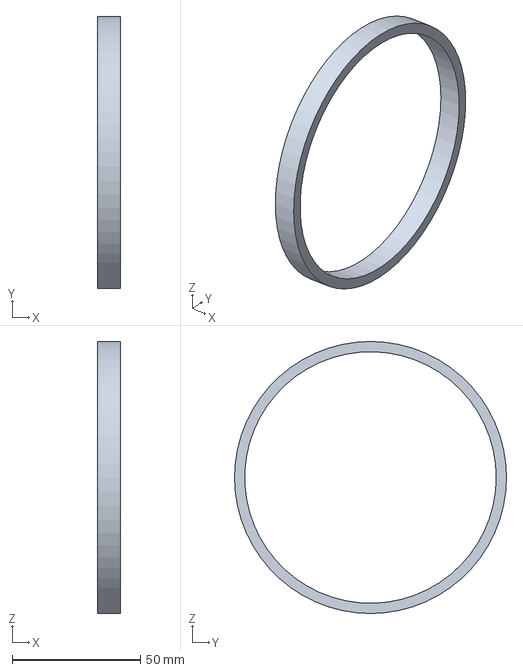
[picture p25: CAD file, 2026-09-17]
designs/p500_sched/cad/parts/igv_unison_ring.step
8.82 x 106.0 x 106.0 mm
