MEO41/jetsuite2/designs/p500_sched/handoff/impeller_cam/hub.step

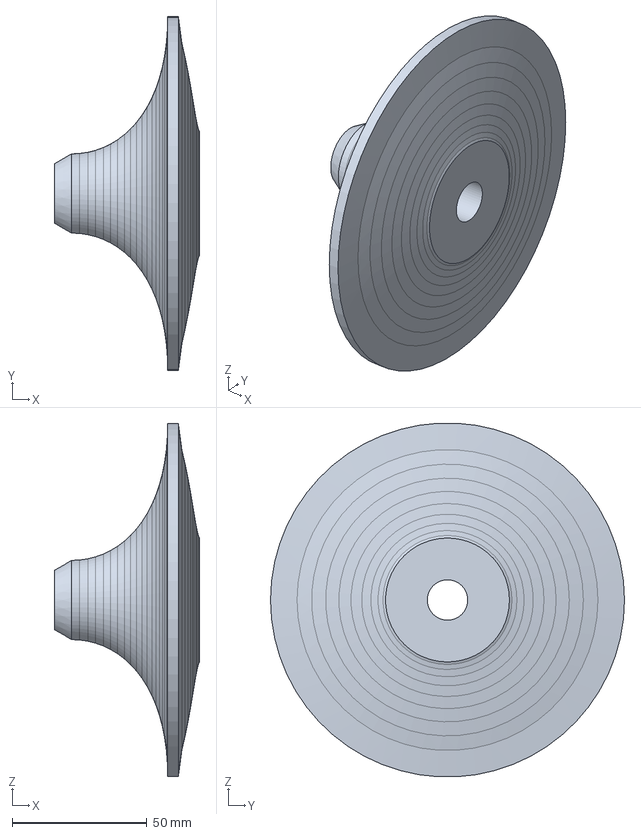
[picture p26: CAD file, 2026-09-17]
designs/p500_sched/handoff/impeller_cam/hub.step
53.9 x 131.4 x 131.2 mm
