MEO41/jetsuite2/designs/p500_sched/handoff/impeller_cfd/passage.step

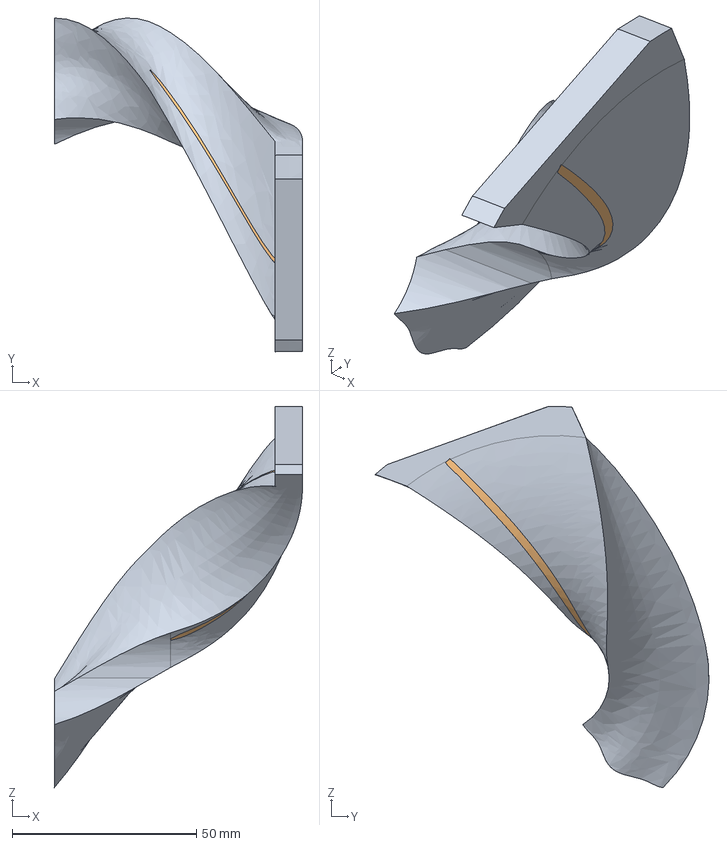
[picture p27: CAD file, 2026-09-17]
designs/p500_sched/handoff/impeller_cfd/passage.step
67.3 x 90.5 x 103.3 mm
