MEO41/jetsuite2/designs/p500/cad/parts/liner_inner.step

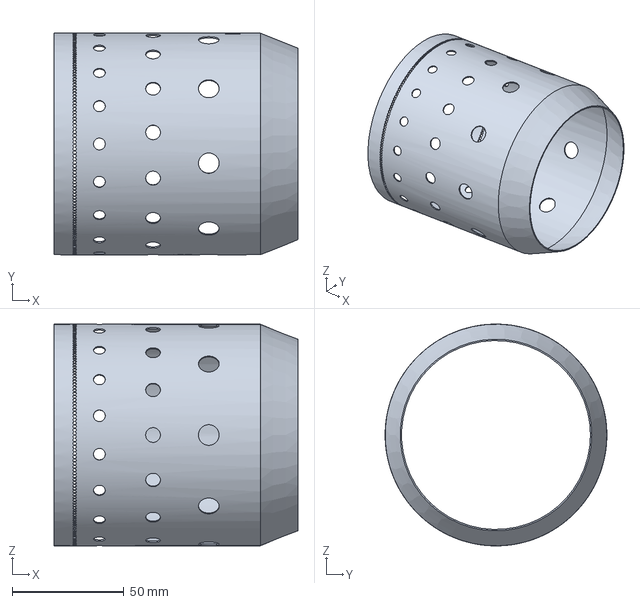
[picture p28: CAD file, 2026-09-16]
designs/p500/cad/parts/liner_inner.step
109.1 x 99.1 x 99.1 mm
