MEO41/jetsuite2/designs/p500_sched/cad/parts/igv_hub_bullet.step

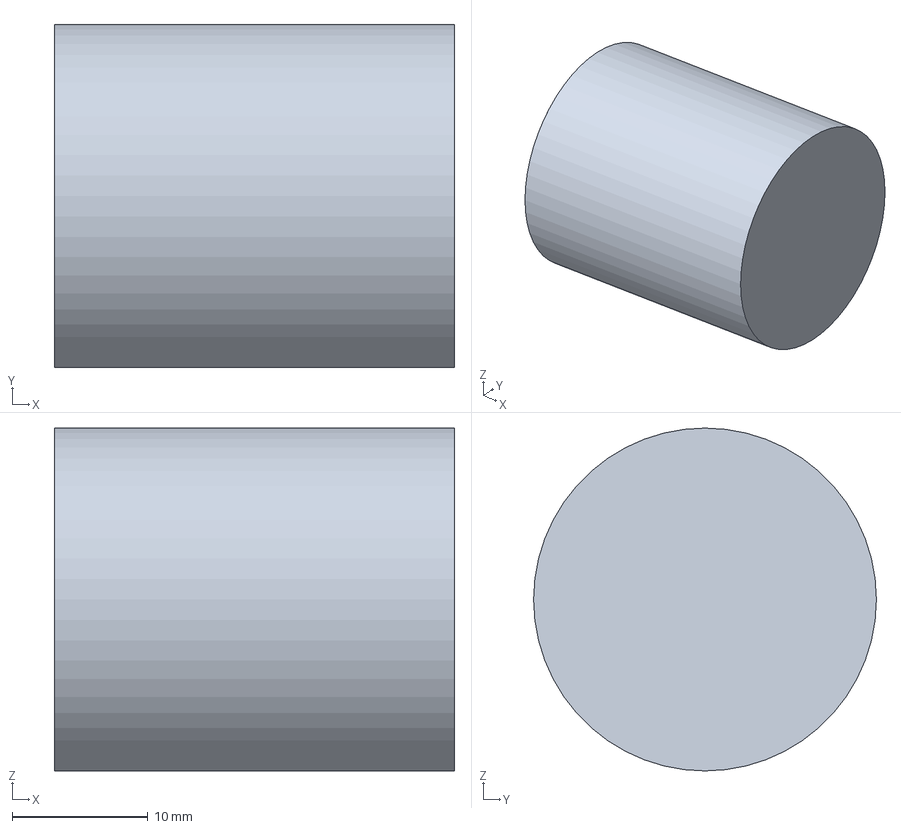
[picture p29: CAD file, 2026-09-17]
designs/p500_sched/cad/parts/igv_hub_bullet.step
29.4 x 25.2 x 25.2 mm
