MEO41/jetsuite2/designs/p500_sched/handoff/impeller_cam/impeller_sharp.step

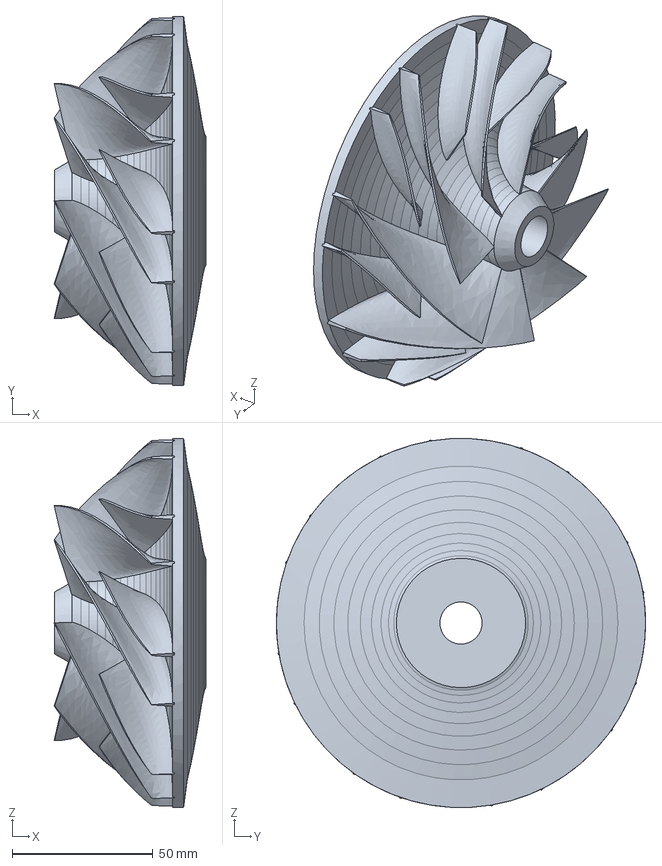
[picture p30: CAD file, 2026-09-17]
designs/p500_sched/handoff/impeller_cam/impeller_sharp.step
54.0 x 131.4 x 131.3 mm
