MEO41/jetsuite2/designs/p500/cad/parts/diffuser_back_plate.step

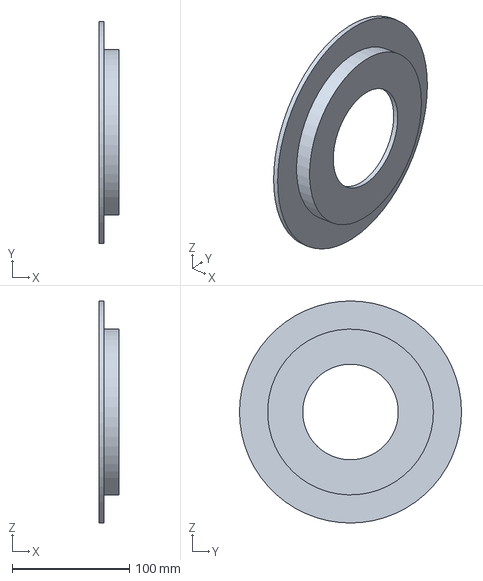
[picture p31: CAD file, 2026-09-16]
designs/p500/cad/parts/diffuser_back_plate.step
16.8 x 189.3 x 189.3 mm
