MEO41/jetsuite2/designs/p500_sched/cad/parts/igv_vanes.step

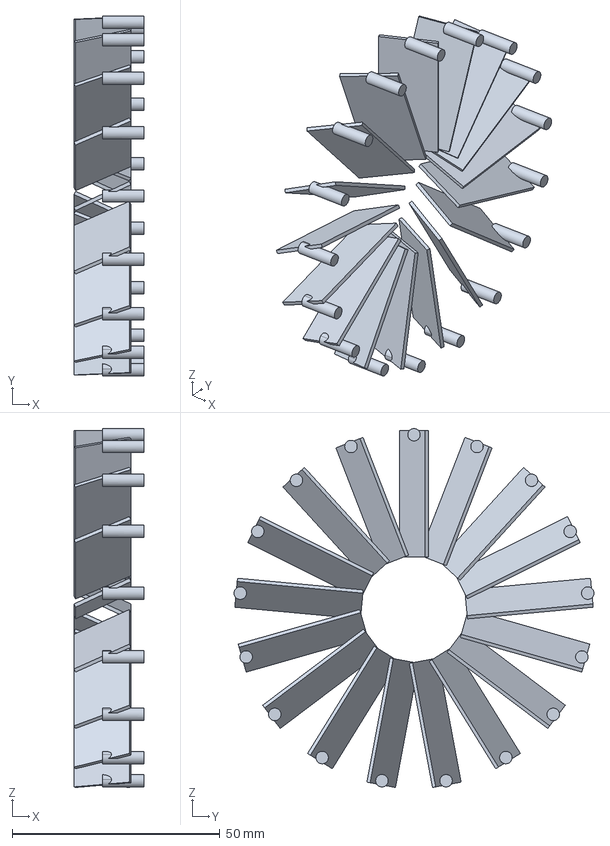
[picture p32: CAD file, 2026-09-17]
designs/p500_sched/cad/parts/igv_vanes.step
16.9 x 86.7 x 86.5 mm
