MEO41/jetsuite2/designs/p500/cad/parts/retaining_ring_rear.step

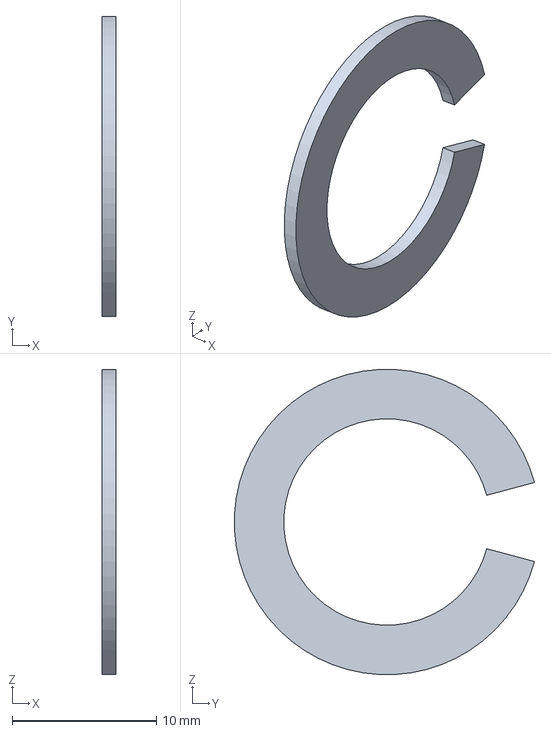
[picture p33: CAD file, 2026-09-16]
designs/p500/cad/parts/retaining_ring_rear.step
1.00 x 20.8 x 21.1 mm
