MEO41/jetsuite2/designs/p500_sched/cad/parts/inlet_shroud.step

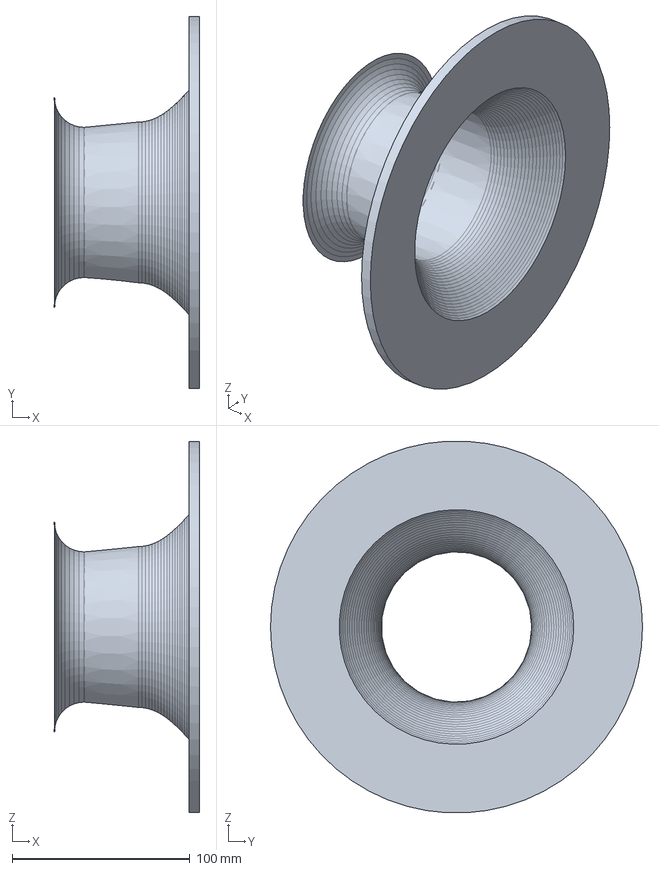
[picture p34: CAD file, 2026-09-17]
designs/p500_sched/cad/parts/inlet_shroud.step
81.6 x 209.3 x 209.0 mm
