MEO41/jetsuite2/designs/p500/cad/parts/hot_casing.step

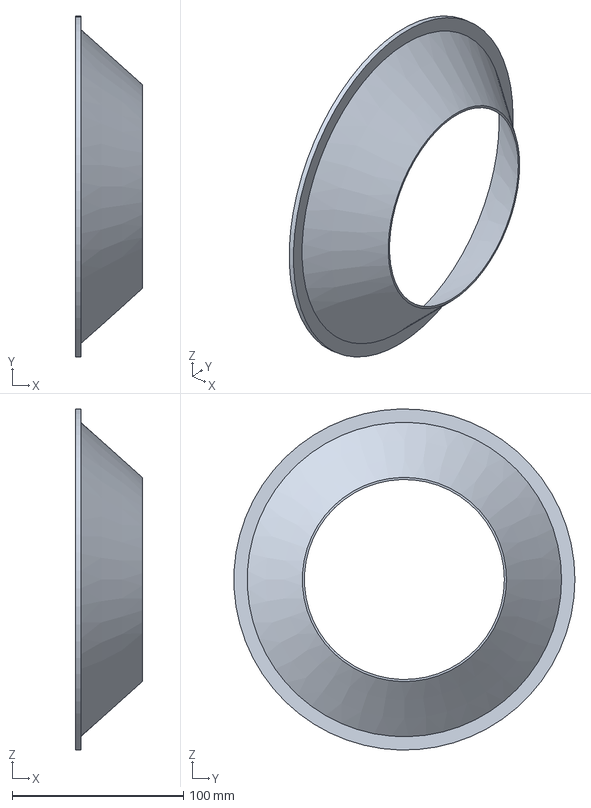
[picture p35: CAD file, 2026-09-16]
designs/p500/cad/parts/hot_casing.step
38.9 x 198.8 x 198.9 mm
