MEO41/jetsuite2/designs/p500/cad/parts/nozzle.step

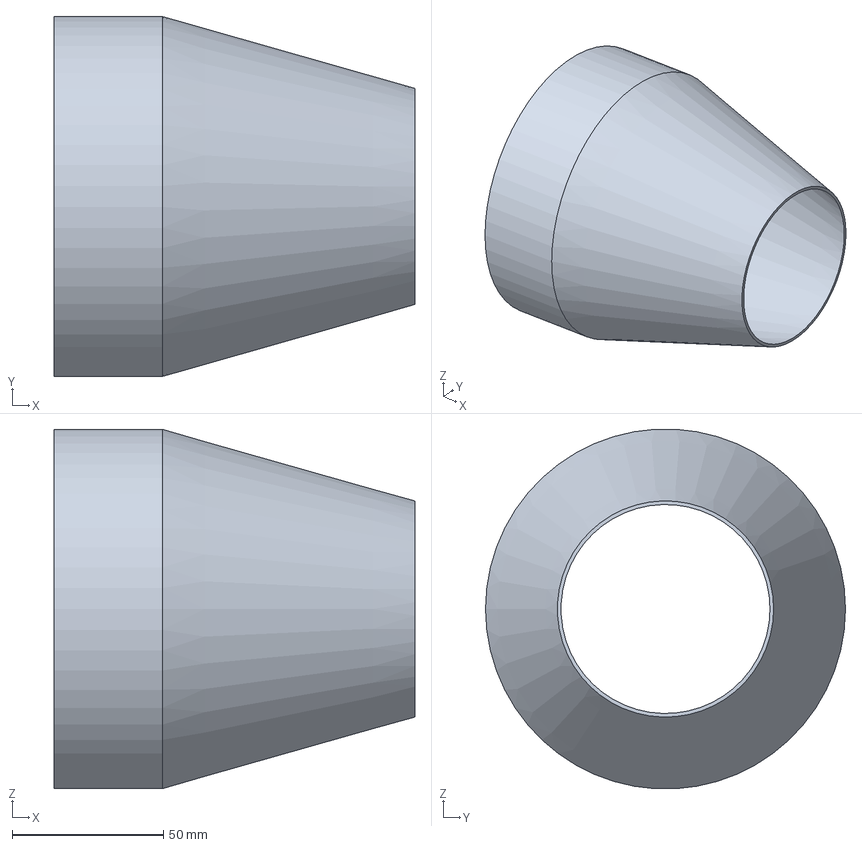
[picture p36: CAD file, 2026-09-16]
designs/p500/cad/parts/nozzle.step
119.3 x 119.0 x 118.8 mm
