MEO41/jetsuite2/designs/p500/cad/parts/shaft_tunnel.step

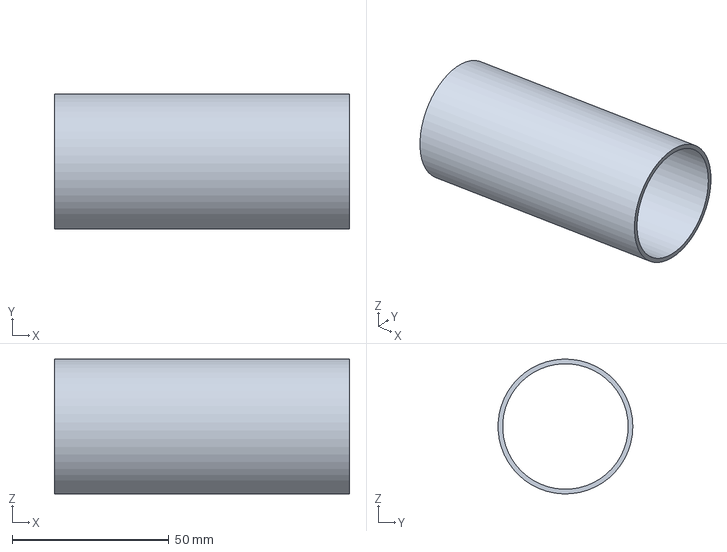
[picture p37: CAD file, 2026-09-16]
designs/p500/cad/parts/shaft_tunnel.step
94.1 x 43.0 x 43.0 mm
