MEO41/jetsuite2/designs/p500/cad/parts/outer_casing.step

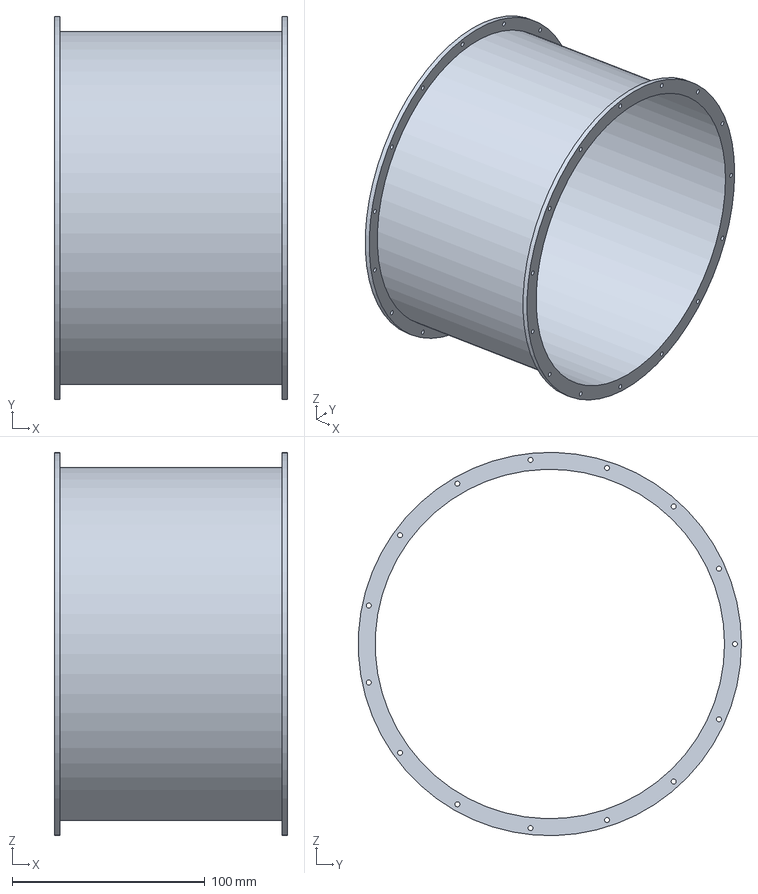
[picture p38: CAD file, 2026-09-16]
designs/p500/cad/parts/outer_casing.step
121.1 x 198.8 x 198.9 mm
