MEO41/jetsuite2/designs/p500/cad/parts/housing_front.step

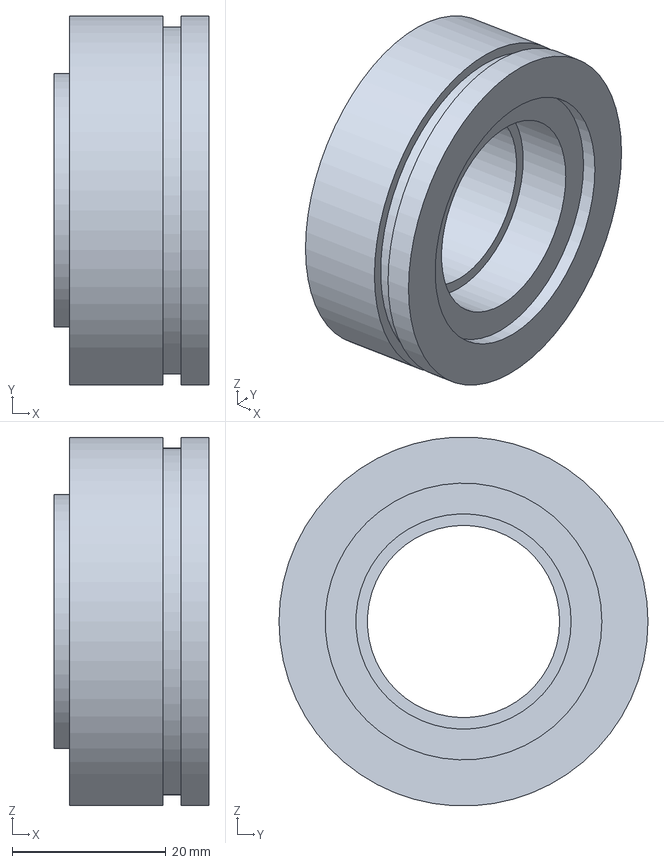
[picture p39: CAD file, 2026-09-16]
designs/p500/cad/parts/housing_front.step
20.1 x 48.0 x 47.9 mm
