MEO41/jetsuite2/designs/p500/cad/parts/vaporisers.step

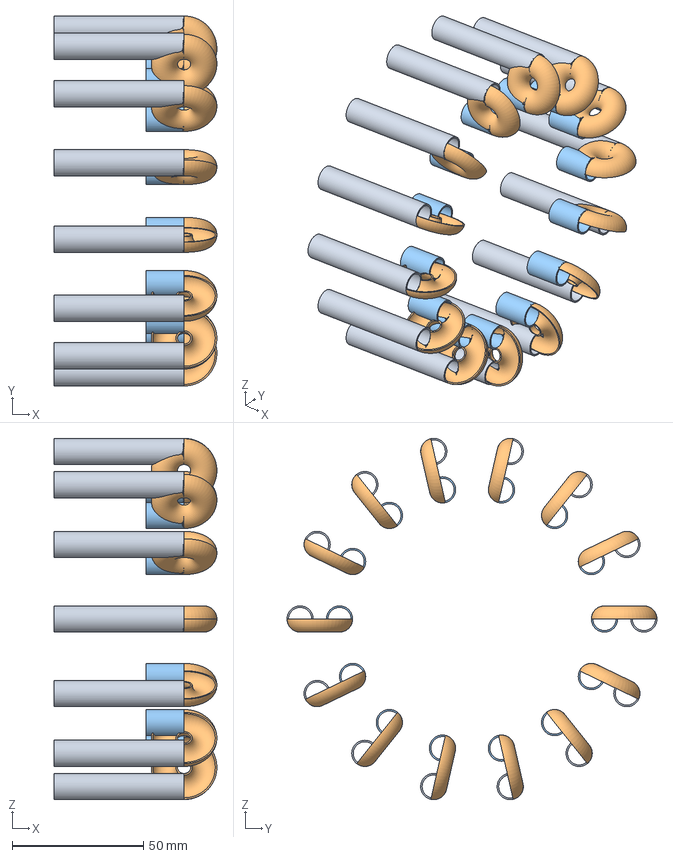
[picture p40: CAD file, 2026-09-16]
designs/p500/cad/parts/vaporisers.step
62.0 x 140.9 x 137.6 mm
