MEO41/jetsuite2/designs/p500/cad/parts/tail_cone_struts.step

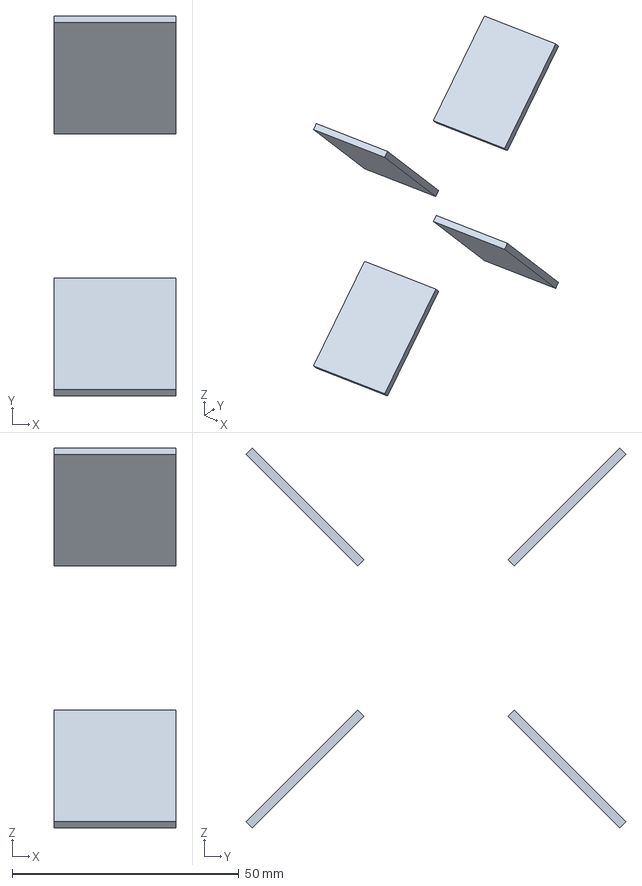
[picture p41: CAD file, 2026-09-16]
designs/p500/cad/parts/tail_cone_struts.step
26.9 x 83.9 x 83.9 mm
