MEO41/jetsuite2/designs/p500/cad/parts/turbine_wheel.step

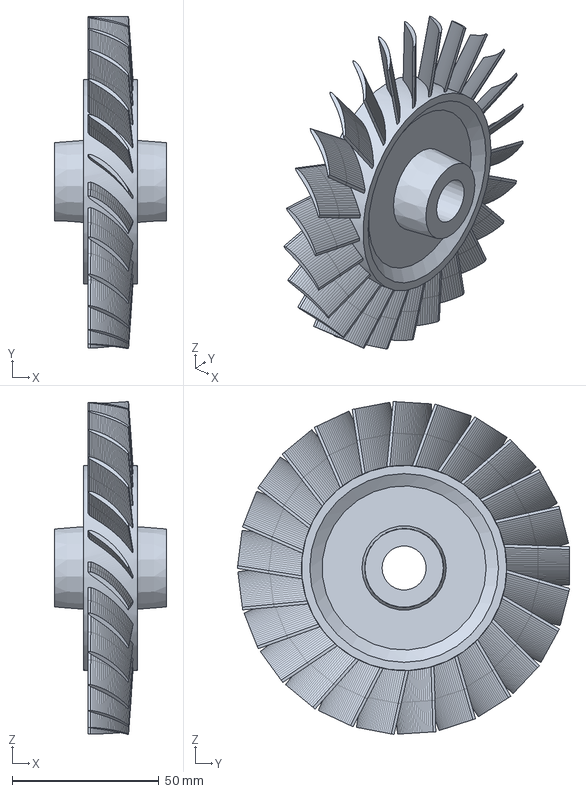
[picture p42: CAD file, 2026-09-16]
designs/p500/cad/parts/turbine_wheel.step
38.2 x 113.1 x 113.3 mm
