MEO41/jetsuite2/designs/p500/cad/parts/tail_cone.step

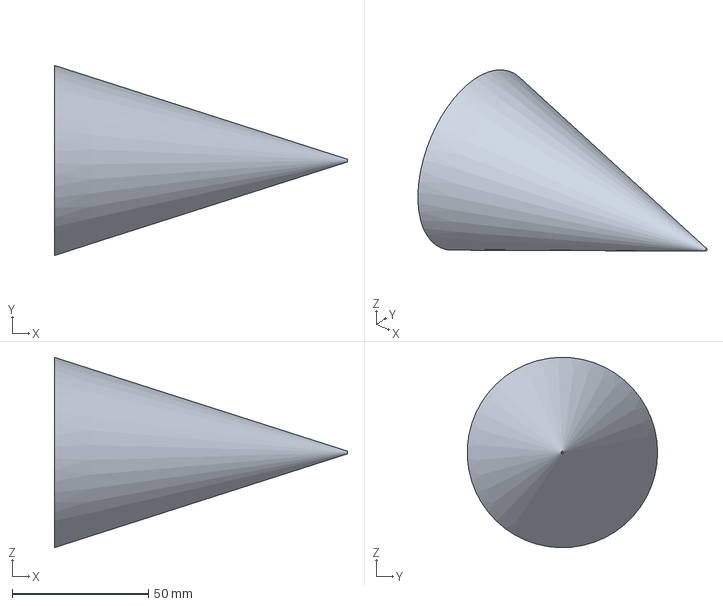
[picture p43: CAD file, 2026-09-16]
designs/p500/cad/parts/tail_cone.step
107.5 x 69.8 x 69.8 mm
