MEO41/jetsuite2/designs/p500/cad/parts/deswirl_vanes.step

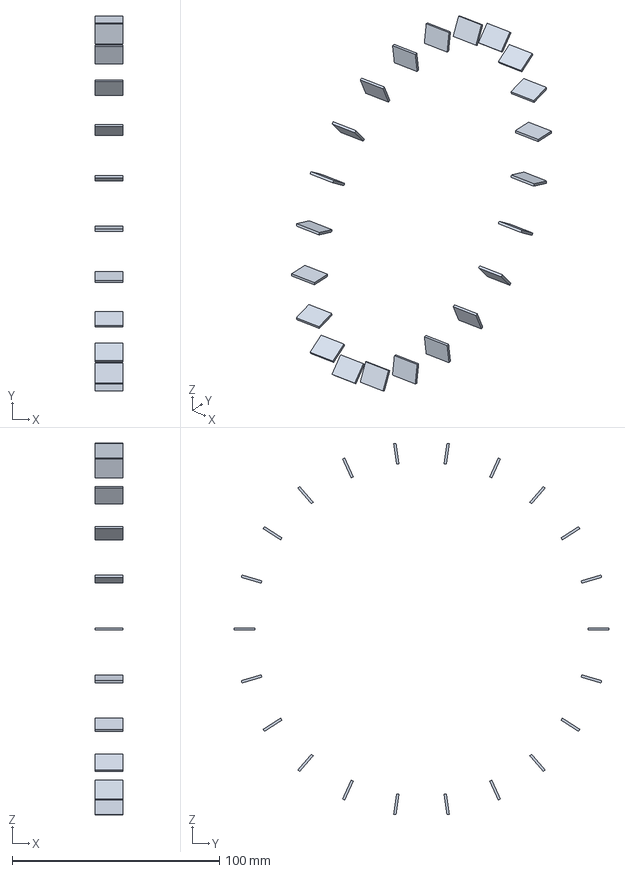
[picture p44: CAD file, 2026-09-16]
designs/p500/cad/parts/deswirl_vanes.step
13.6 x 180.8 x 179.2 mm
