MEO41/jetsuite2/designs/p500/cad/parts/shaft.step

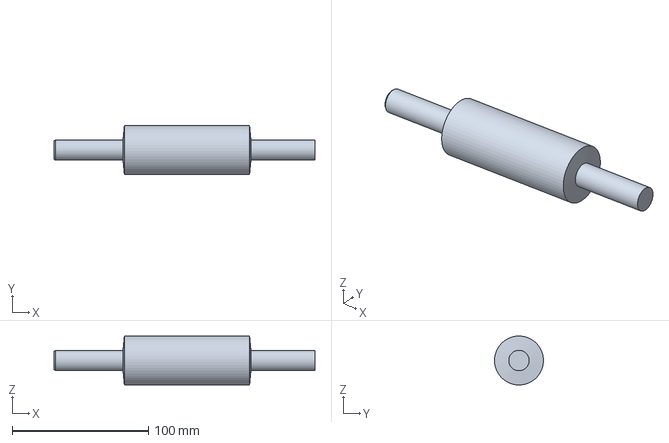
[picture p45: CAD file, 2026-09-16]
designs/p500/cad/parts/shaft.step
191.8 x 36.0 x 36.0 mm
