MEO41/jetsuite2/designs/p500/cad/parts/ngv_ring.step

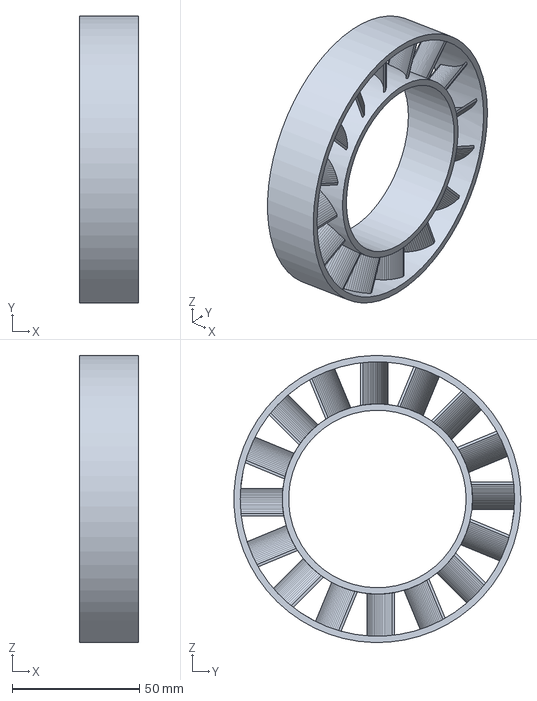
[picture p46: CAD file, 2026-09-16]
designs/p500/cad/parts/ngv_ring.step
23.1 x 112.7 x 112.7 mm
