MEO41/jetsuite2/designs/p500/cad/parts/diffuser_vanes.step

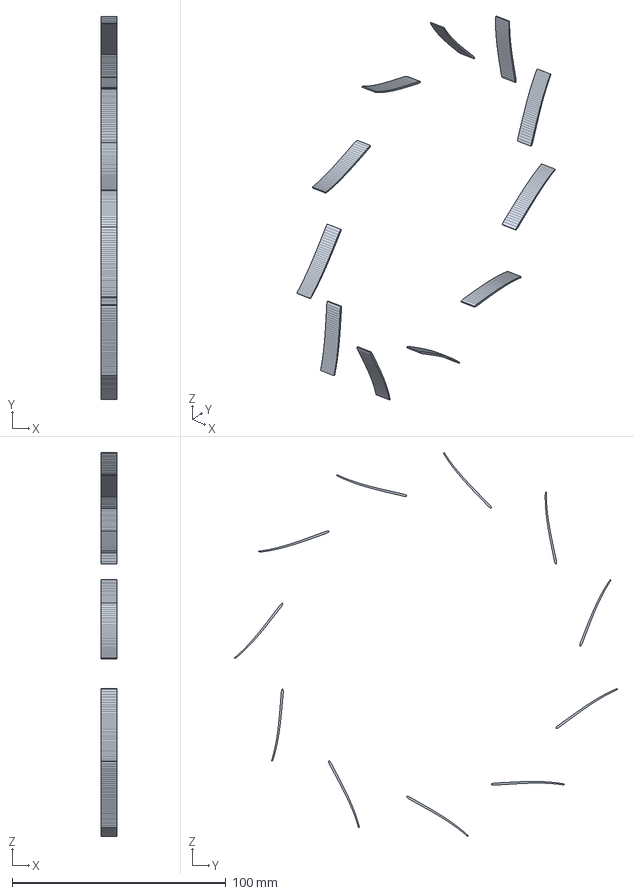
[picture p47: CAD file, 2026-09-16]
designs/p500/cad/parts/diffuser_vanes.step
7.69 x 179.2 x 179.4 mm
