MEO41/jetsuite2/designs/p500/cad/parts/oring_front.step

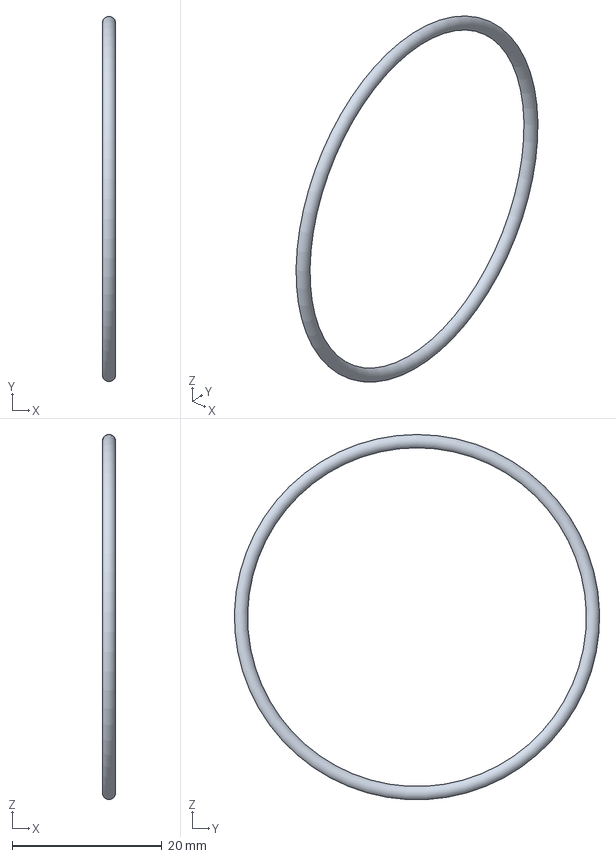
[picture p48: CAD file, 2026-09-16]
designs/p500/cad/parts/oring_front.step
1.78 x 48.7 x 48.7 mm
