MEO41/jetsuite2/designs/p500/cad/parts/inner_casing.step

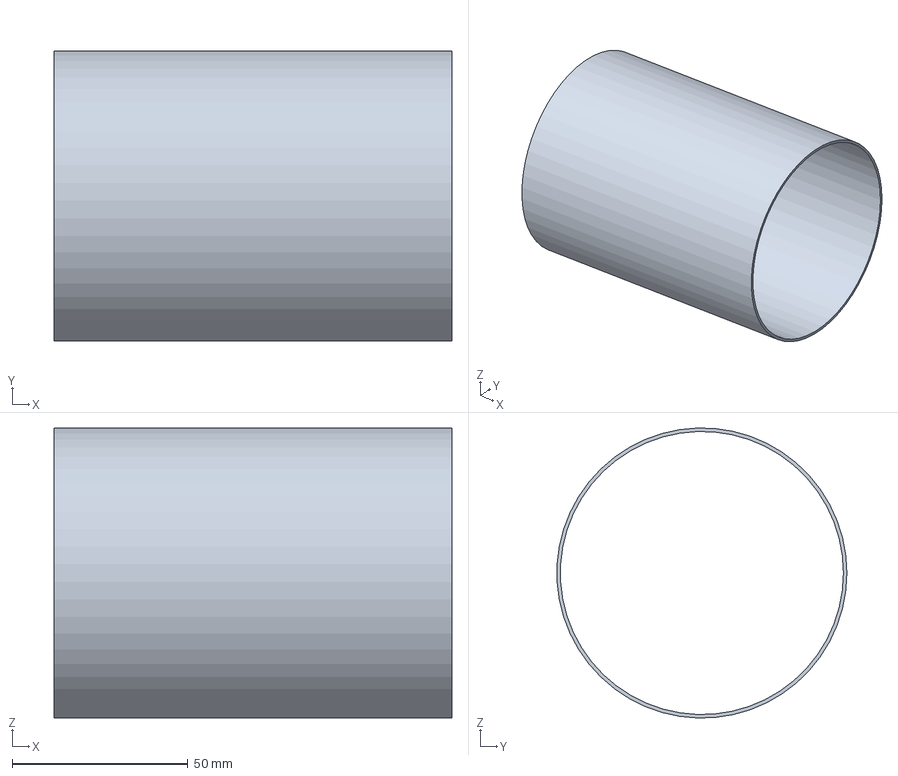
[picture p49: CAD file, 2026-09-16]
designs/p500/cad/parts/inner_casing.step
113.1 x 82.3 x 82.4 mm
