MEO41/jetsuite2/designs/p500/cad/parts/egt_probe.step

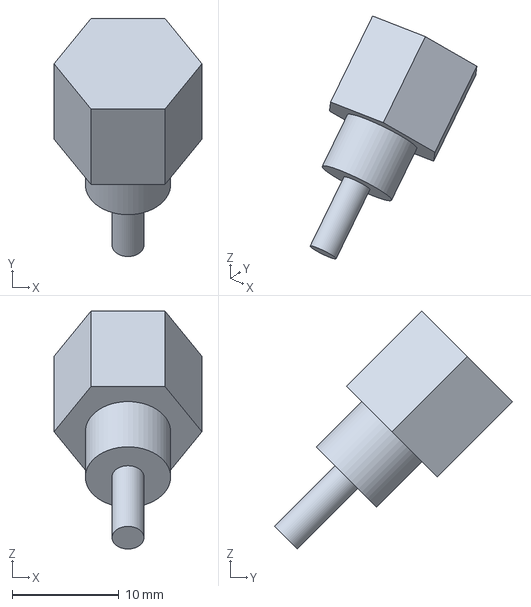
[picture p50: CAD file, 2026-09-16]
designs/p500/cad/parts/egt_probe.step
13.9 x 22.3 x 22.3 mm
