MEO41/jetsuite2/designs/p500/cad/parts/turbine_shroud.step

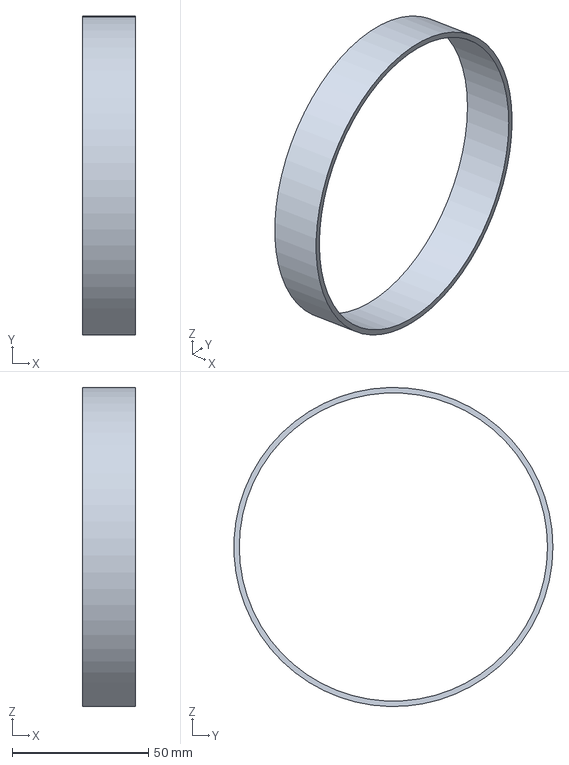
[picture p51: CAD file, 2026-09-16]
designs/p500/cad/parts/turbine_shroud.step
19.3 x 117.0 x 117.1 mm
