MEO41/jetsuite2/designs/p500/cad/parts/igniter_1.step

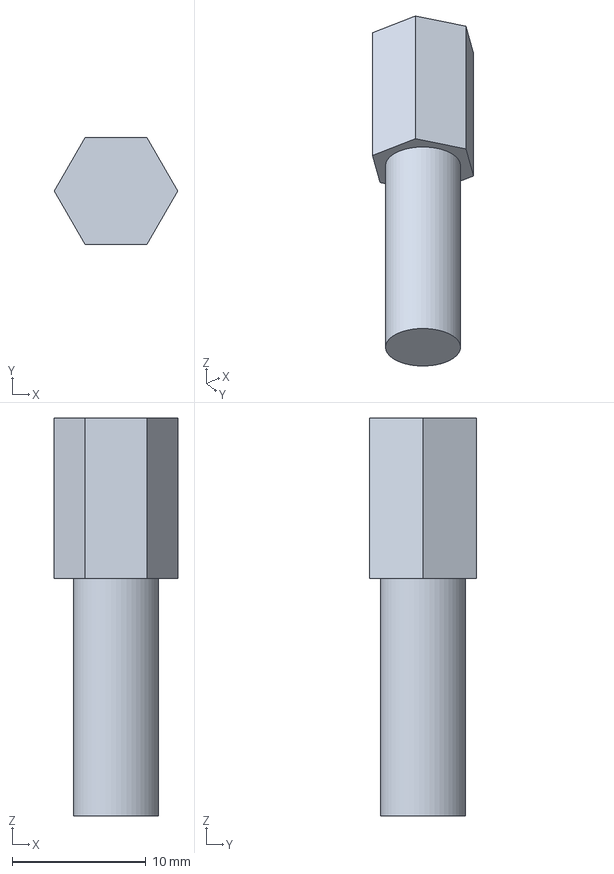
[picture p52: CAD file, 2026-09-16]
designs/p500/cad/parts/igniter_1.step
9.24 x 8.00 x 29.8 mm
