MEO41/jetsuite2/designs/p500/cad/parts/liner_dome.step

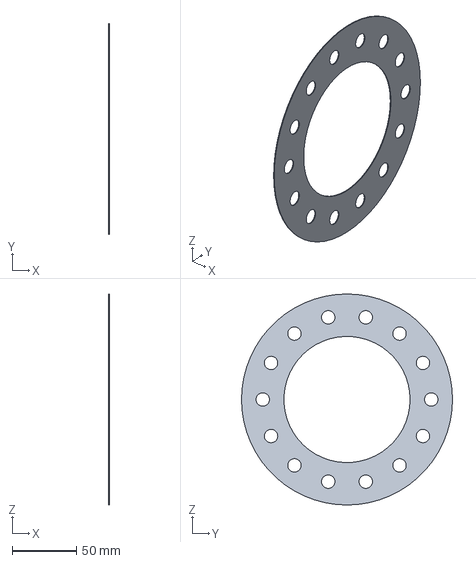
[picture p53: CAD file, 2026-09-16]
designs/p500/cad/parts/liner_dome.step
0.6 x 163.8 x 163.8 mm
