MEO41/jetsuite2/designs/p500/cad/parts/deswirl_inner_wall.step

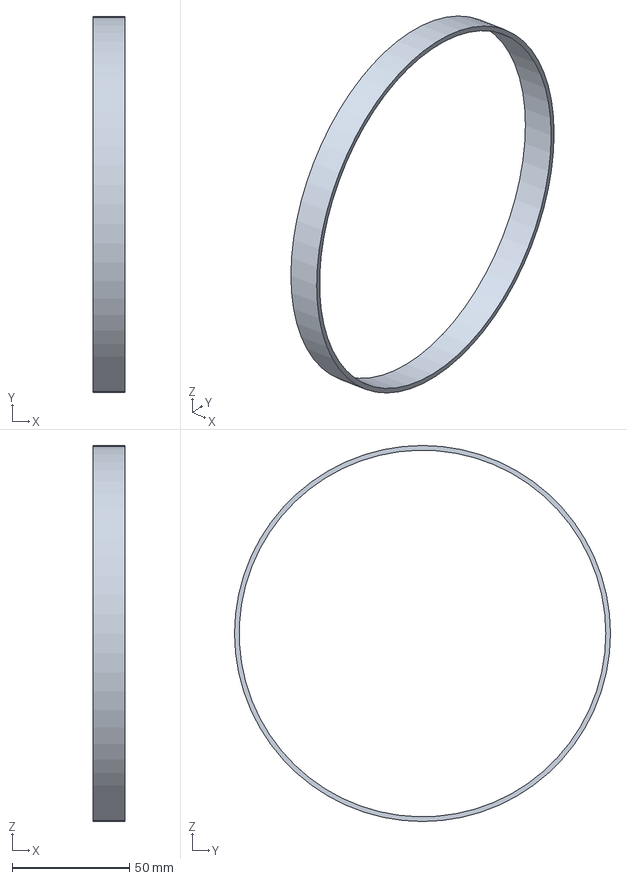
[picture p54: CAD file, 2026-09-16]
designs/p500/cad/parts/deswirl_inner_wall.step
13.6 x 160.2 x 160.2 mm
