MEO41/jetsuite2/designs/p500/cad/parts/bearing_rear.step

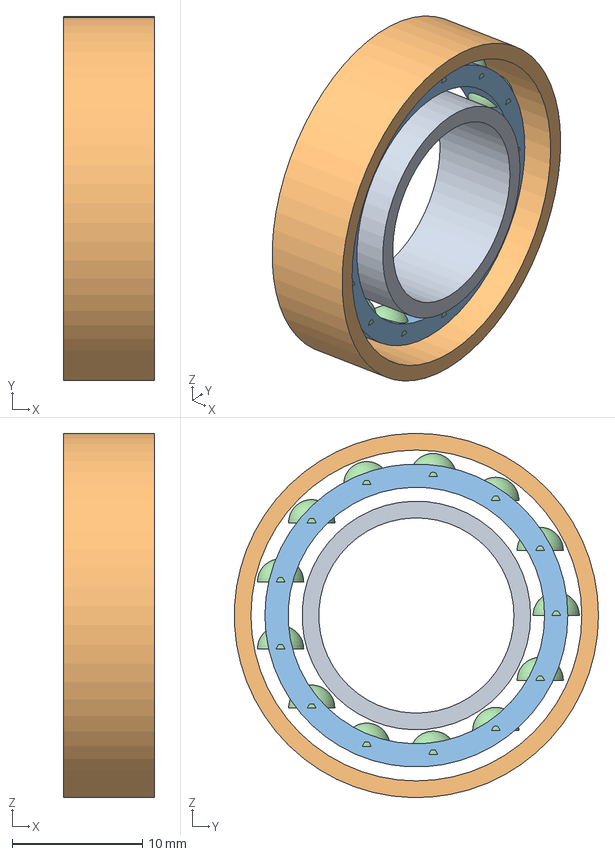
[picture p55: CAD file, 2026-09-16]
designs/p500/cad/parts/bearing_rear.step
7.00 x 28.0 x 28.0 mm
