MEO41/jetsuite2/designs/p500/cad/parts/liner_outer.step

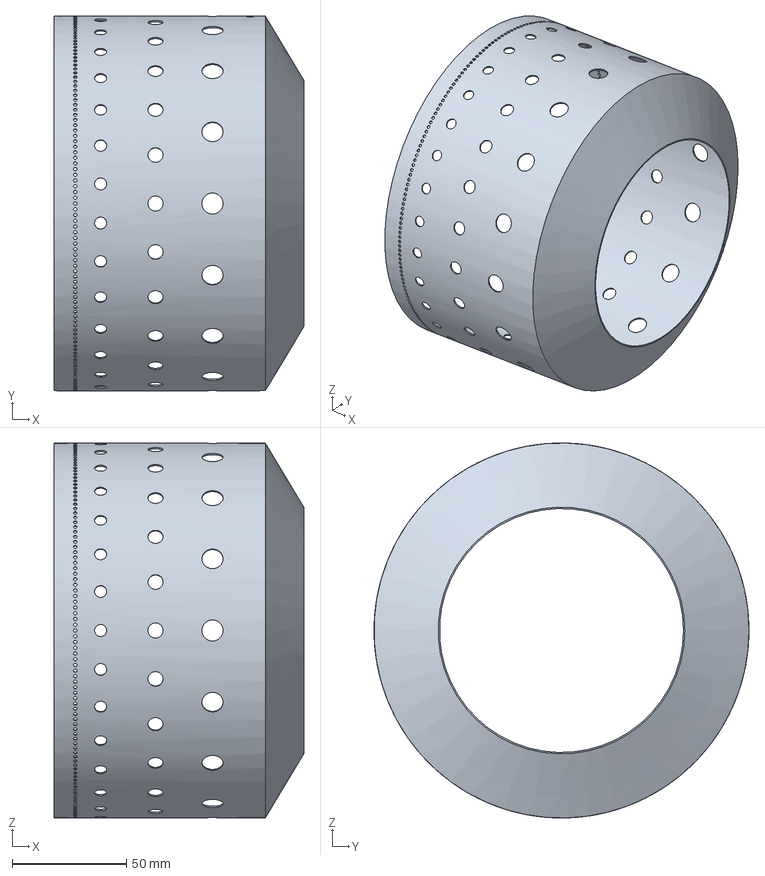
[picture p56: CAD file, 2026-09-16]
designs/p500/cad/parts/liner_outer.step
109.1 x 163.8 x 163.8 mm
