MEO41/jetsuite2/designs/p500/cad/parts/housing_rear.step

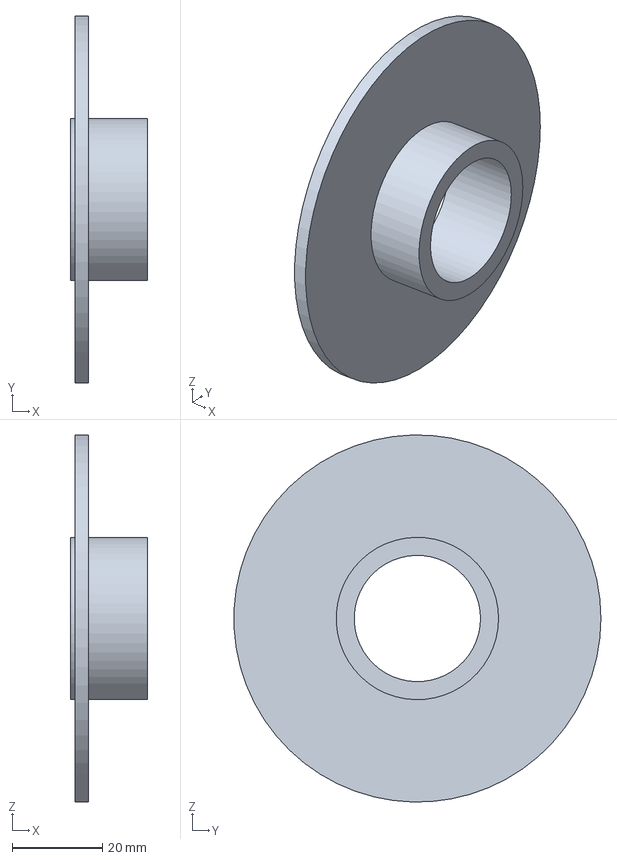
[picture p57: CAD file, 2026-09-16]
designs/p500/cad/parts/housing_rear.step
17.0 x 81.4 x 81.4 mm
