MEO41/jetsuite2/(list of files, cad)

Other CAD files:
designs/p500/cad/parts/retaining_ring_front.step
designs/p500/cad/parts/impeller.step
designs/p500/cad/parts/bearing_front.step
designs/p500/cad/parts/flange_screws_front.step
designs/p500/cad/parts/flange_screws_rear.step
designs/p500/cad/parts/impeller_nut.step
designs/p500/cad/parts/turbine_nut.step
