MEO41/jetsuite2/designs/p500/analysis/testbench_log.csv

t_s | N_rpm | N_frac | EGT_K | T04_K | P3_Pa | Wf_kg_s | thrust_N | W_kg_s | vib_um | T_metal_K
0.00 | 2274 | 0.0314 | 288.4 | 288.4 | 99415 | 0.00000 | 0.0 | 0.0214 | 0.0 | 288.2
0.05 | 2372 | 0.0327 | 288.5 | 288.5 | 99426 | 0.00000 | 0.0 | 0.0224 | 0.0 | 288.2
0.10 | 2469 | 0.0341 | 288.5 | 288.5 | 99437 | 0.00000 | 0.0 | 0.0234 | 0.0 | 288.2
0.15 | 2566 | 0.0354 | 288.5 | 288.5 | 99449 | 0.00000 | 0.0 | 0.0243 | 0.0 | 288.2
0.20 | 2663 | 0.0367 | 288.5 | 288.5 | 99461 | 0.00000 | 0.0 | 0.0253 | 0.0 | 288.2
0.25 | 2759 | 0.0381 | 288.6 | 288.6 | 99473 | 0.00000 | 0.0 | 0.0262 | 0.0 | 288.2
0.30 | 2854 | 0.0394 | 288.6 | 288.6 | 99486 | 0.00000 | 0.0 | 0.0272 | 0.0 | 288.2
0.35 | 2949 | 0.0407 | 288.6 | 288.6 | 99499 | 0.00000 | 0.0 | 0.0281 | 0.0 | 288.2
0.40 | 3043 | 0.0420 | 288.7 | 288.7 | 99513 | 0.00000 | 0.0 | 0.0290 | 0.0 | 288.2
0.45 | 3136 | 0.0433 | 288.7 | 288.7 | 99527 | 0.00000 | 0.0 | 0.0300 | 0.0 | 288.2
0.50 | 3228 | 0.0445 | 288.7 | 288.7 | 99541 | 0.00000 | 0.0 | 0.0309 | 0.0 | 288.2
0.55 | 3320 | 0.0458 | 288.8 | 288.8 | 99556 | 0.00000 | 0.0 | 0.0318 | 0.0 | 288.2
0.60 | 3412 | 0.0471 | 288.8 | 288.8 | 99571 | 0.00000 | 0.0 | 0.0327 | 0.0 | 288.2
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
