MEO41/jetsuite2/designs/p500_sched/analysis/testbench_log.csv

t_s | N_rpm | N_frac | EGT_K | T04_K | P3_Pa | Wf_kg_s | thrust_N | W_kg_s | vib_um | T_metal_K
0.00 | 2274 | 0.0314 | 288.4 | 288.4 | 99412 | 0.00000 | 0.0 | 0.0194 | 0.0 | 288.2
0.05 | 2374 | 0.0327 | 288.4 | 288.4 | 99422 | 0.00000 | 0.0 | 0.0203 | 0.0 | 288.2
0.10 | 2472 | 0.0341 | 288.5 | 288.5 | 99434 | 0.00000 | 0.0 | 0.0212 | 0.0 | 288.2
0.15 | 2570 | 0.0354 | 288.5 | 288.5 | 99445 | 0.00000 | 0.0 | 0.0221 | 0.0 | 288.2
0.20 | 2668 | 0.0368 | 288.5 | 288.5 | 99457 | 0.00000 | 0.0 | 0.0230 | 0.0 | 288.2
0.25 | 2765 | 0.0381 | 288.5 | 288.5 | 99469 | 0.00000 | 0.0 | 0.0238 | 0.0 | 288.2
0.30 | 2861 | 0.0395 | 288.6 | 288.6 | 99482 | 0.00000 | 0.0 | 0.0247 | 0.0 | 288.2
0.35 | 2957 | 0.0408 | 288.6 | 288.6 | 99495 | 0.00000 | 0.0 | 0.0256 | 0.0 | 288.2
0.40 | 3052 | 0.0421 | 288.6 | 288.6 | 99508 | 0.00000 | 0.0 | 0.0264 | 0.0 | 288.2
0.45 | 3147 | 0.0434 | 288.7 | 288.7 | 99522 | 0.00000 | 0.0 | 0.0273 | 0.0 | 288.2
0.50 | 3241 | 0.0447 | 288.7 | 288.7 | 99536 | 0.00000 | 0.0 | 0.0281 | 0.0 | 288.2
0.55 | 3335 | 0.0460 | 288.7 | 288.7 | 99550 | 0.00000 | 0.0 | 0.0290 | 0.0 | 288.2
0.60 | 3428 | 0.0473 | 288.8 | 288.8 | 99565 | 0.00000 | 0.0 | 0.0298 | 0.0 | 288.2
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
