MEO41/jetsuite2/src/jetsuite2/validation/data/hecc/flowpath_hub.csv

x_m | r_m
-0.127 | 0.06299199999999999
-0.1251077762 | 0.0620898936
-0.1232362788 | 0.061212603
-0.1213854824 | 0.0603601282
-0.11955470119999999 | 0.0595317326
-0.1177434018 | 0.058726705
-0.11595107619999999 | 0.0579444104
-0.11417741959999998 | 0.0571842392
-0.11242192399999999 | 0.056445480199999995
-0.1106842084 | 0.055727574599999996
-0.10896384099999999 | 0.0550298366
-0.10726044079999998 | 0.054351732800000004
-0.1055736268 | 0.05369267899999999
-0.1039029672 | 0.0530521672
-0.10224813179999999 | 0.052429664
-0.1006087142 | 0.0518247122
-0.09898428259999999 | 0.051236803799999994
-0.097374583 | 0.050665583199999996
-0.0957791328 | 0.0501105424
-0.0941976272 | 0.0495713766
-0.092629736 | 0.0490476794
-0.091075002 | 0.04853909519999999
-0.0895331966 | 0.0480452938
-0.08800388799999999 | 0.0475659704
-0.0864867968 | 0.0471008202
-0.0849814912 | 0.046649513
-0.08348771719999999 | 0.046211845599999996
-0.08200511919999999 | 0.0457875132
-0.080533367 | 0.0453762872
-0.0790721558 | 0.044977939
-0.07762113 | 0.04459224
-0.0761799848 | 0.044218961599999995
-0.0747484408 | 0.0438579514
-0.073326117 | 0.04350895539999999
-0.07191278479999999 | 0.043171846599999994
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
