MEO41/jetsuite2/src/jetsuite2/validation/data/hecc/flowpath_shroud.csv

x_m | r_m
-0.127 | 0.128905
-0.1254387128 | 0.128323467
-0.12388044819999998 | 0.12775498959999998
-0.1223252824 | 0.12719961859999998
-0.120773698 | 0.1266554998
-0.11922615219999999 | 0.1261209568
-0.11768282279999999 | 0.1255953292
-0.11614381139999999 | 0.1250779566
-0.1146092704 | 0.1245683056
-0.1130791998 | 0.1240658682
-0.1115536758 | 0.123570492
-0.110032673 | 0.1230817452
-0.108516166 | 0.1225995262
-0.10700415479999999 | 0.12212380959999998
-0.1054965886 | 0.12165434139999999
-0.10399339120000001 | 0.12119112159999999
-0.10249451180000001 | 0.12073420099999999
-0.1009998488 | 0.1202836558
-0.09950942759999999 | 0.1198391304
-0.09802317199999999 | 0.11940059939999999
-0.09654075179999999 | 0.1189691296
-0.09506188759999999 | 0.11854533059999998
-0.09358744299999999 | 0.11812602739999999
-0.0921183324 | 0.11770766399999999
-0.09065308259999999 | 0.117295422
-0.0891892044 | 0.1168978866
-0.0877271804 | 0.11651302579999999
-0.0862692458 | 0.1161321274
-0.08481590859999999 | 0.11575318479999999
-0.0833660258 | 0.11538041439999999
-0.0819188862 | 0.11501605139999999
-0.0804746676 | 0.11465923219999999
-0.0790335224 | 0.1143092456
-0.0775952474 | 0.11396647260000001
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
