MEO41/jetsuite2/designs/p500/analysis/testbench_run.png

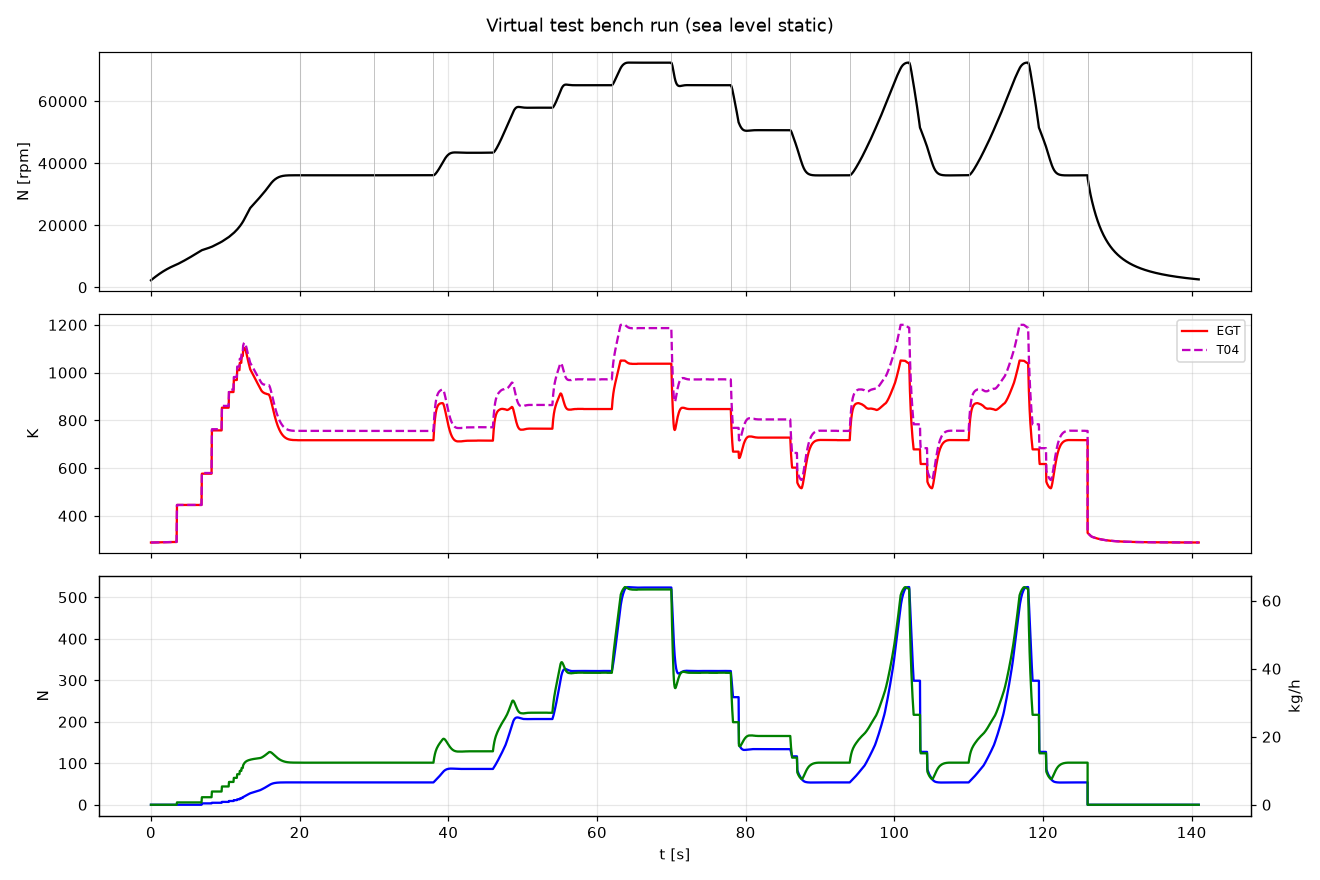
designs/p500/analysis/testbench_run.png
