MEO41/jetsuite2/designs/p500_sched/analysis/testbench_run.png

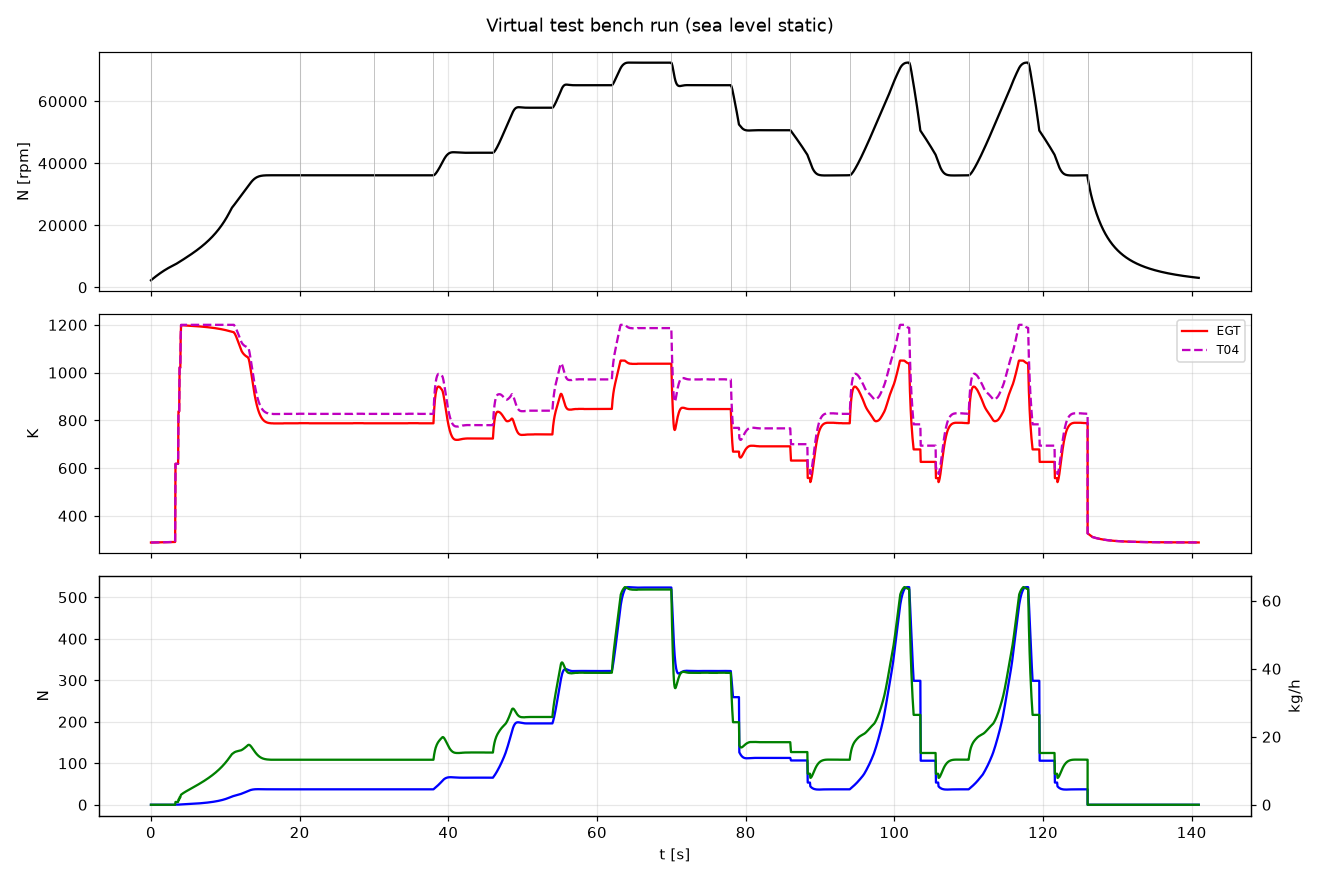
designs/p500_sched/analysis/testbench_run.png
