MEO41/jetsuite2/designs/p500_sched/handoff/impeller_cfd/lowspeed/history_low.csv

Time_Iter | Outer_Iter | Inner_Iter | "rms[Rho]" | "rms[RhoU]" | "rms[RhoV]" | "rms[RhoW]" | "rms[RhoE]" | "Avg_Massflow" | "Avg_Massflow" | "Avg_Mach" | "Avg_Temp" | "Avg_Press" | "Avg_Press" | "Avg_Density" | "Avg_Enthalpy" | "Avg_NormalVel" | "Uniformity" | Secondary_Strength | Momentum_Distortion | Secondary_Over_Uniformity | "Avg_TotalTemp" | "Avg_TotalTemp" | "Avg_TotalPress" | "Avg_TotalPress" | "Pressure_Drop" | Avg_Massflow(INLET) | Avg_Massflow(OUTLET) | Avg_Press(INLET) | Avg_Press(OUTLET) | Avg_TotalTemp(INLET) | Avg_TotalTemp(OUTLET) | Avg_TotalPress(INLET) | Avg_TotalPress(OUTLET)
0 | 0 | 0 | -4.550602535 | -3.118638906 | -3.408222084 | -3.435165893 | 0.2620000516 | 0.0001447928791 | 0.0001447928791 | 0.4117659994 | 583.7223953 | 214903.6693 | 214903.6693 | 2.561862733 | 592373.431 | -5.995862385 | 87.7525012 | 89.26408986 | -4.560680781e-05 | 1.904813636 | 589.6005396 | 589.6005396 | 223089.2908 | 223089.2908 | 21527.70302 | 0.02912405257 | -0.02897925969 | 96687.98316 | 118215.6862 | 288.439237 | 301.1613026 | 97670.06561 | 125419.2252
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
