MEO41/jetsuite2/designs/p500_sched/handoff/impeller_cfd/rstbl/history_rstbl.csv

Time_Iter | Outer_Iter | Inner_Iter | "rms[Rho]" | "rms[RhoU]" | "rms[RhoV]" | "rms[RhoW]" | "rms[RhoE]" | "rms[k]" | "rms[w]" | "Avg_Massflow" | "Avg_Massflow" | "Avg_Mach" | "Avg_Temp" | "Avg_Press" | "Avg_Press" | "Avg_Density" | "Avg_Enthalpy" | "Avg_NormalVel" | "Uniformity" | Secondary_Strength | Momentum_Distortion | Secondary_Over_Uniformity | "Avg_TotalTemp" | "Avg_TotalTemp" | "Avg_TotalPress" | "Avg_TotalPress" | "Pressure_Drop" | Avg_Massflow(INLET) | Avg_Massflow(OUTLET) | Avg_Press(INLET) | Avg_Press(OUTLET) | Avg_TotalTemp(INLET) | Avg_TotalTemp(OUTLET) | Avg_TotalPress(INLET) | Avg_TotalPress(OUTLET)
0 | 0 | 0 | -4.992651989 | -3.671410354 | -3.938978418 | -3.367112444 | 0.4681362305 | -3.695193964 | 0.0277506003 | -0.001788016838 | -0.001788016838 | 0.3675264199 | 570.9702576 | 190244.6959 | 190244.6959 | 2.321323629 | 577808.445 | -21.84603572 | 114.3153852 | 37.22116091 | -0.02099607258 | 0.547348633 | 575.0710229 | 575.0710229 | 195059.7791 | 195059.7791 | -2874.430771 | 0.03280878014 | -0.03459679698 | 96559.56332 | 93685.13255 | 288.2946345 | 286.7763884 | 97833.72461 | 97226.05452
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
