MEO41/jetsuite2/designs/p500_sched/handoff/impeller_cfd/stbl/history_stbl.csv

Time_Iter | Outer_Iter | Inner_Iter | "rms[Rho]" | "rms[RhoU]" | "rms[RhoV]" | "rms[RhoW]" | "rms[RhoE]" | "Avg_Massflow" | "Avg_Massflow" | "Avg_Mach" | "Avg_Temp" | "Avg_Press" | "Avg_Press" | "Avg_Density" | "Avg_Enthalpy" | "Avg_NormalVel" | "Uniformity" | Secondary_Strength | Momentum_Distortion | Secondary_Over_Uniformity | "Avg_TotalTemp" | "Avg_TotalTemp" | "Avg_TotalPress" | "Avg_TotalPress" | "Pressure_Drop" | Avg_Massflow(INLET) | Avg_Massflow(OUTLET) | Avg_Press(INLET) | Avg_Press(OUTLET) | Avg_TotalTemp(INLET) | Avg_TotalTemp(OUTLET) | Avg_TotalPress(INLET) | Avg_TotalPress(OUTLET)
0 | 0 | 0 | -4.989260872 | -3.180815358 | -3.598712933 | -3.382492446 | 0.4723698722 | -0.0009898940426 | -0.0009898940426 | 0.3641792397 | 570.1155396 | 189659.9072 | 189659.9072 | 2.317582984 | 576822.1011 | -20.48789044 | 113.4714619 | 37.52845232 | -2.068276005e-05 | 0.5608104357 | 574.1220053 | 574.1220053 | 194351.519 | 194351.519 | -3578.357506 | 0.03313433496 | -0.034124229 | 96619.13236 | 93040.77485 | 288.3821995 | 285.7398057 | 97891.20554 | 96460.31349
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
