MEO41/jetsuite2/designs/p500_sched/handoff/impeller_cfd/stnospl/history_stnospl.csv

Time_Iter | Outer_Iter | Inner_Iter | "rms[Rho]" | "rms[RhoU]" | "rms[RhoV]" | "rms[RhoW]" | "rms[RhoE]" | "Avg_Massflow" | "Avg_Massflow" | "Avg_Mach" | "Avg_Temp" | "Avg_Press" | "Avg_Press" | "Avg_Density" | "Avg_Enthalpy" | "Avg_NormalVel" | "Uniformity" | Secondary_Strength | Momentum_Distortion | Secondary_Over_Uniformity | "Avg_TotalTemp" | "Avg_TotalTemp" | "Avg_TotalPress" | "Avg_TotalPress" | "Pressure_Drop" | Avg_Massflow(INLET) | Avg_Massflow(OUTLET) | Avg_Press(INLET) | Avg_Press(OUTLET) | Avg_TotalTemp(INLET) | Avg_TotalTemp(OUTLET) | Avg_TotalPress(INLET) | Avg_TotalPress(OUTLET)
0 | 0 | 0 | -5.010171025 | -3.179422271 | -3.606989227 | -3.392882206 | 0.4514598011 | -0.0009898940744 | -0.0009898940744 | 0.3641792401 | 570.1155395 | 189659.9071 | 189659.9071 | 2.317582983 | 576822.101 | -20.48789057 | 113.4714621 | 37.52845232 | -2.068276232e-05 | 0.5608104345 | 574.1220052 | 574.1220052 | 194351.5189 | 194351.5189 | -3578.357621 | 0.03313433498 | -0.03412422905 | 96619.13237 | 93040.77475 | 288.3821995 | 285.7398056 | 97891.20556 | 96460.31339
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
