MEO41/jetsuite2/(commit log)

2026-09-16 jetsuitev3 with more fidelty and analytical analysis ccapabilities
    [microturbojet_database.csv, testbench_log.csv]
2026-09-17 further developed the suite to be more multi fidelity and analysis tool driven
    [annulus_axial.csv, annulus_box.csv, annulus_solid.csv, annulus_swirl.csv, blade_angles.csv, datasheet_points.csv, duct.cfg, duct7592.cfg]
